migtam628/NetScope/firmware/os/README.md

# Device OS integration

Example systemd units for the engine and the kiosk UI. They describe the intended setup (docs/13) and have **not been run on a device**: there is no OS image, device-tree overlay or update bundle in this repository yet.
