migtam628/NetScope/hardware/kicad/coprocessor-pins.md

# Coprocessor pin plan (U40, STM32G0B1CBU6, UFQFPN-48)

Generated by `tools/gen_kicad.py` from `tools/main_sheets.py`; the schematic sheet is drawn from the same table.
Functions in the last column are checked against the alternate-function list in KiCad's library symbol.
Not yet checked against the reference manual: boot entry through PA14-BOOT0 and the UCPD dead-battery pins.

| Pin | Name | Net | Peripheral function |
|---|---|---|---|
| 1 | PC13 | KEY_PWR | SYS_WKUP2 |
| 2 | PC14 | WM_MUX_EN | GPIO |
| 3 | PC15 | WM_RANGE0 | GPIO |
| 4 | VBAT | +3V3_AON | supply |
| 5 | VREF+ | +3V3_AON | supply |
| 6 | VDD | +3V3_AON | supply |
| 7, 49 | VSS | GND | supply |
| 8 | PF0 | WM_RANGE1 | GPIO |
| 9 | PF1 | SFP_PWR_EN | GPIO |
| 10 | PF2 | COPROC_NRST | GPIO |
| 11 | PA0 | WM_ADC_V | ADC1_IN0 |
| 12 | PA1 | WM_ADC_I | ADC1_IN1 |
| 13 | PA2 | COPROC_UART_TX_R | USART2_TX |
| 14 | PA3 | COPROC_UART_RX | USART2_RX |
| 15 | PA4 | XT_ADC | ADC1_IN4 |
| 16 | PA5 | CC1_SENSE | ADC1_IN5 |
| 17 | PA6 | CC2_SENSE | ADC1_IN6 |
| 18 | PA7 | BUZZ | TIM17_CH1 |
| 19 | PB0 | LED3 | TIM3_CH3 |
| 20 | PB1 | LED4 | TIM3_CH4 |
| 21 | PB2 | WM_RET_A1 | GPIO |
| 22 | PB10 | POE_I2C_SCL | I2C2_SCL |
| 23 | PB11 | POE_I2C_SDA | I2C2_SDA |
| 24 | PB12 | CHG_INT | GPIO |
| 25 | PB13 | POE_ISO_EN | GPIO |
| 26 | PB14 | RELAY_TEST_EN | GPIO |
| 27 | PB15 | SOM_PWR_EN | GPIO |
| 28 | PA8 | SOM_RUN | GPIO |
| 29 | PA9/UCPD1_DBCC1 | WM_DRV_A0 | GPIO |
| 30 | PC6 | LED1 | TIM3_CH1 |
| 31 | PC7 | LED2 | TIM3_CH2 |
| 32 | PA10/UCPD1_DBCC2 | WM_DRV_A1 | GPIO |
| 33 | PA9/PA11 | WM_DRV_A2 | GPIO |
| 34 | PA10/PA12 | WM_RET_A0 | GPIO |
| 35 | PA13 | SWDIO | SYS_SWDIO |
| 36 | PA14 | SWCLK | SYS_SWCLK |
| 37 | PA15 | KEY_FN | GPIO |
| 38 | PD0 | KEY_UP | GPIO |
| 39 | PD1 | KEY_DOWN | GPIO |
| 40 | PD2 | KEY_LEFT | GPIO |
| 41 | PD3 | KEY_RIGHT | GPIO |
| 42 | PB3 | WM_RET_A2 | GPIO |
| 43 | PB4 | SPARE_PB4 | GPIO |
| 44 | PB5 | KEY_OK | SYS_WKUP6 |
| 45 | PB6 | KEY_BACK | GPIO |
| 46 | PB7 | KEY_HOME | GPIO |
| 47 | PB8 | PWR_I2C_SCL | I2C1_SCL |
| 48 | PB9 | PWR_I2C_SDA | I2C1_SDA |
