migtam628/NetScope/hardware/pcb/floorplan_report.md

# Floorplan report

Generated by `tools/render_floorplan.py`. Geometry checks on approximate part envelopes; not a layout review.

- main: 88 x 88 mm = 78.3 cm2 with tabs; placed part area 65.9 cm2 = 43% of both sides (before passives and routing)
- lower: 88 x 56 mm = 49.3 cm2 with tabs; placed part area 8.0 cm2 = 8% of both sides (before passives and routing)

## Nets crossing between the boards (8)

`KEYS`, `STATUS_LEDS`, `BUZZ`, `USBC_VBUS`, `USBC_D`, `USBC_CC`, `+3V3_AON`, `GND`

These set the board-to-board cables (J50 signal, J51 power).

## Violations

None.
