migtam628/NetScope/mechanical/out/check_report.md

# Enclosure check report

Generated by `mechanical/enclosure.py`. Geometry checks only: this is not a tolerance analysis, drop simulation or mouldability review.

| Part | Valid solid | Bodies | Bounding box (mm) | Volume (cm3) | Mass (g) |
|---|---|---:|---|---:|---:|
| front_shell | yes | 1 | 108.0 x 212.0 x 15.5 | 57.3 | 66 |
| rear_shell | yes | 1 | 108.0 x 212.0 x 26.8 | 83.1 | 96 |
| battery_door | yes | 1 | 73.4 x 79.4 x 2.5 | 14.5 | 17 |
| bumper | yes | 1 | 114.0 x 218.0 x 30.0 | 51.1 | 61 |

## Interference (shell vs. module keep-outs)

| Shell part | Module | Overlap (mm3) |
|---|---|---:|
| front_shell | ref_display | 0.0 |
| front_shell | pcb_main | 0.0 |
| front_shell | pcb_lower | 0.0 |
| front_shell | ref_cells | 0.0 |
| rear_shell | ref_display | 0.0 |
| rear_shell | pcb_main | 0.0 |
| rear_shell | pcb_lower | 0.0 |
| rear_shell | ref_cells | 0.0 |
| battery_door | ref_display | 0.0 |
| battery_door | pcb_main | 0.0 |
| battery_door | pcb_lower | 0.0 |
| battery_door | ref_cells | 0.0 |

## Interference between internal modules

| Module | Module | Overlap (mm3) |
|---|---|---:|
| ref_display | pcb_main | 0.0 |
| ref_display | pcb_lower | 0.0 |
| ref_display | ref_cells | 0.0 |
| pcb_main | pcb_lower | 0.0 |
| pcb_main | ref_cells | 0.0 |
| pcb_lower | ref_cells | 0.0 |

## Depth stack at the battery

front wall 2.5 + display 8.0 + gap 2.0 + PCB 1.6 + clearance 0.6 + cell 21.6 + clearance 0.6 + door 2.5 = **39.4 mm** against 40.0 mm outside depth (fits, +0.6 mm).

Overall result: **pass**
