migtam628/NetScope/docs/img/ui-autodiagnose.png

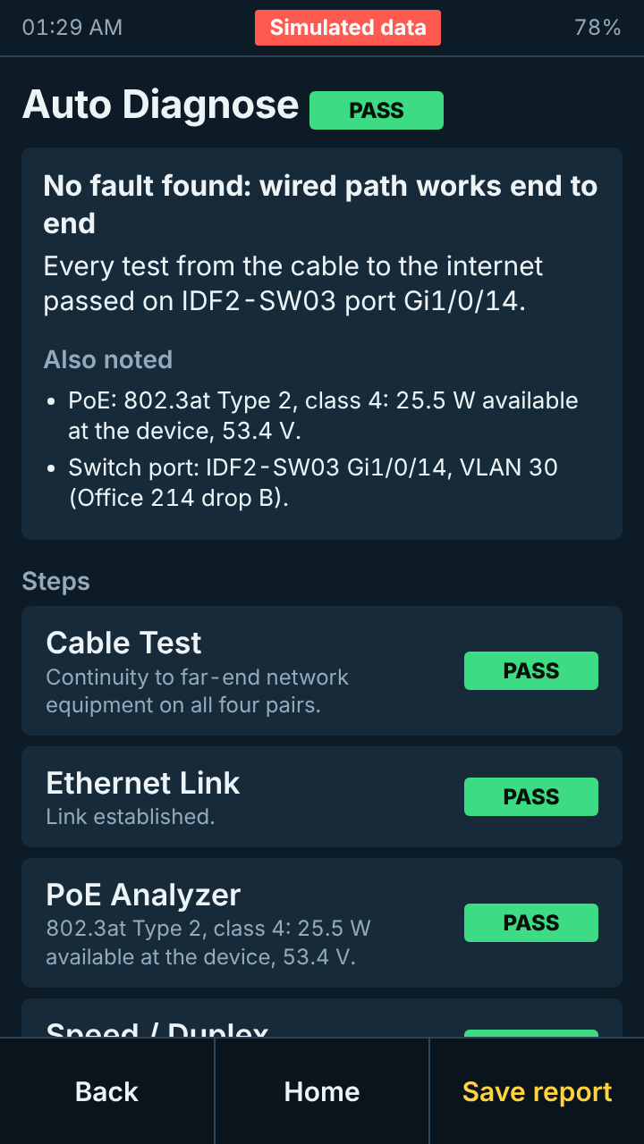
docs/img/ui-autodiagnose.png
