migtam628/NetScope/docs/img/ui-fiber.png

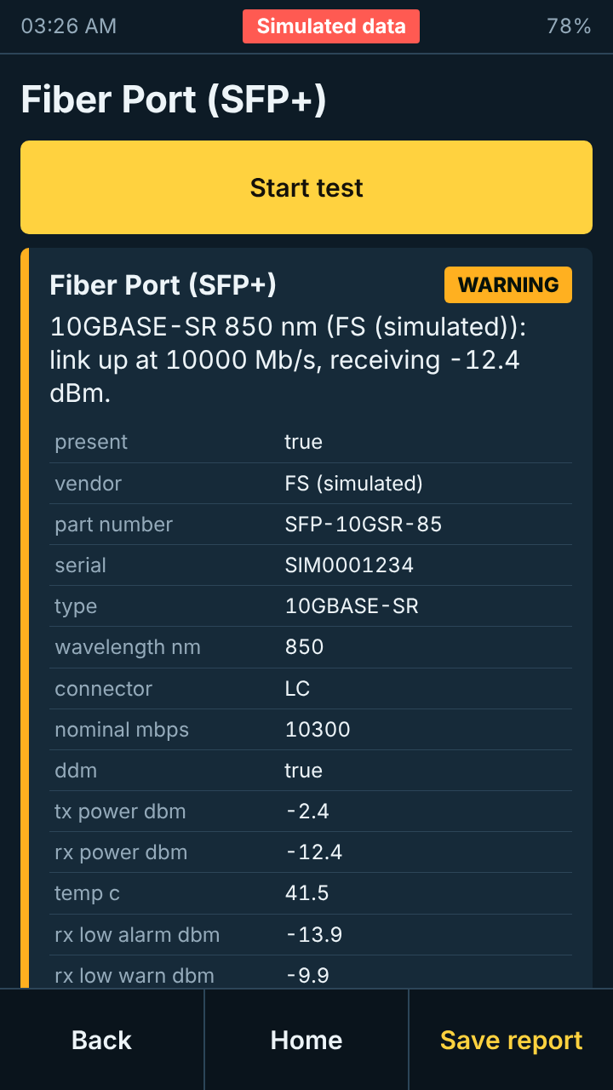
docs/img/ui-fiber.png
