migtam628/NetScope/mechanical/renders/01_front.png

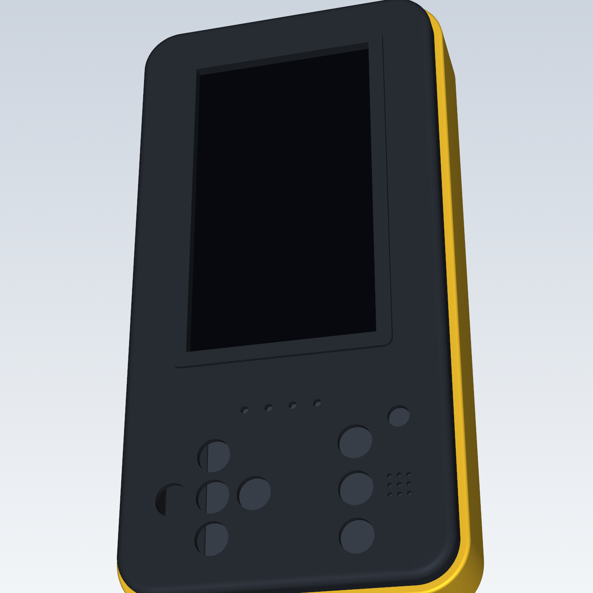
mechanical/renders/01_front.png
