migtam628/NetScope/mechanical/renders/02_back.png

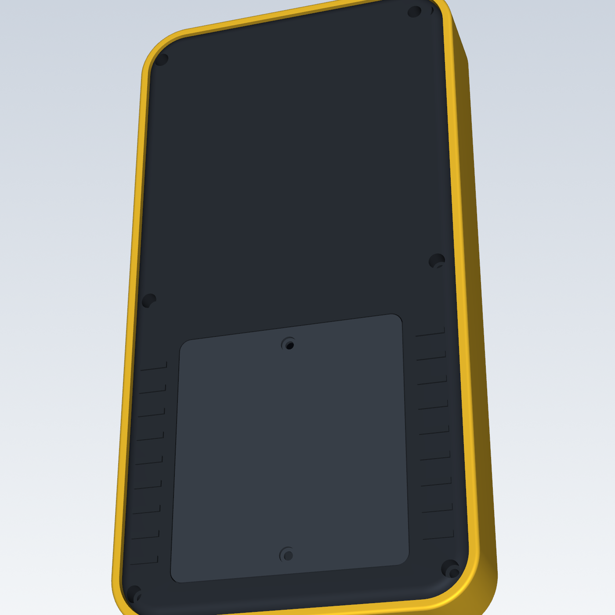
mechanical/renders/02_back.png
