migtam628/NetScope/mechanical/renders/03_top_end_ports.png

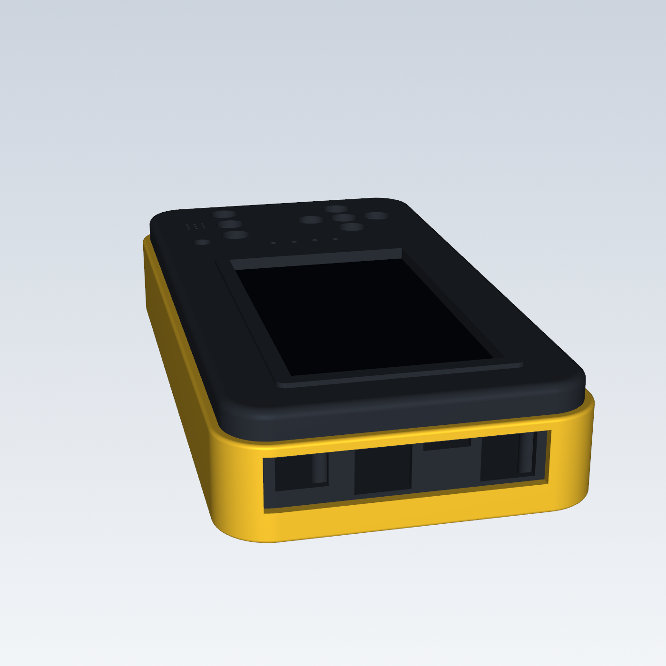
mechanical/renders/03_top_end_ports.png
