migtam628/NetScope/mechanical/renders/04_boards_in_rear_shell.png

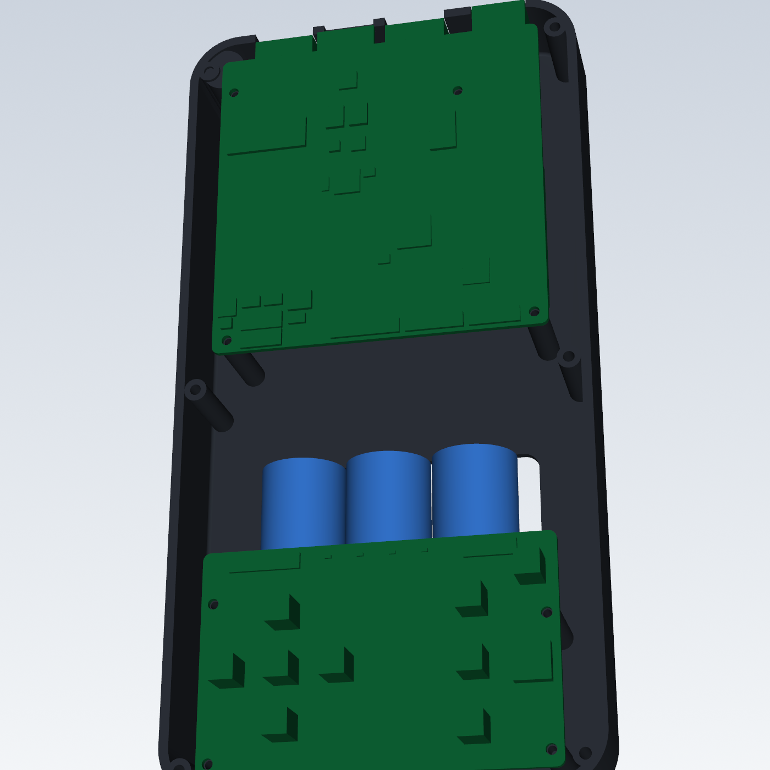
mechanical/renders/04_boards_in_rear_shell.png
