migtam628/NetScope/mechanical/renders/05_boards_back_side.png

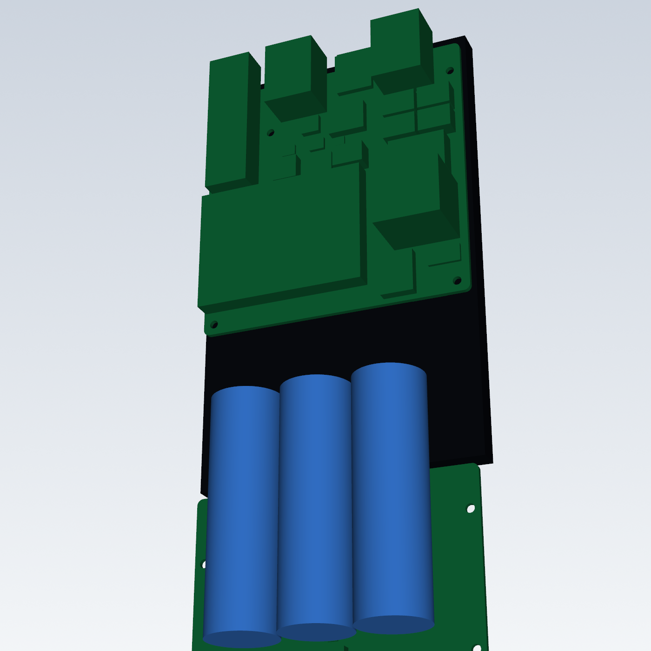
mechanical/renders/05_boards_back_side.png
