migtam628/NetScope/mechanical/renders/06_exploded.png

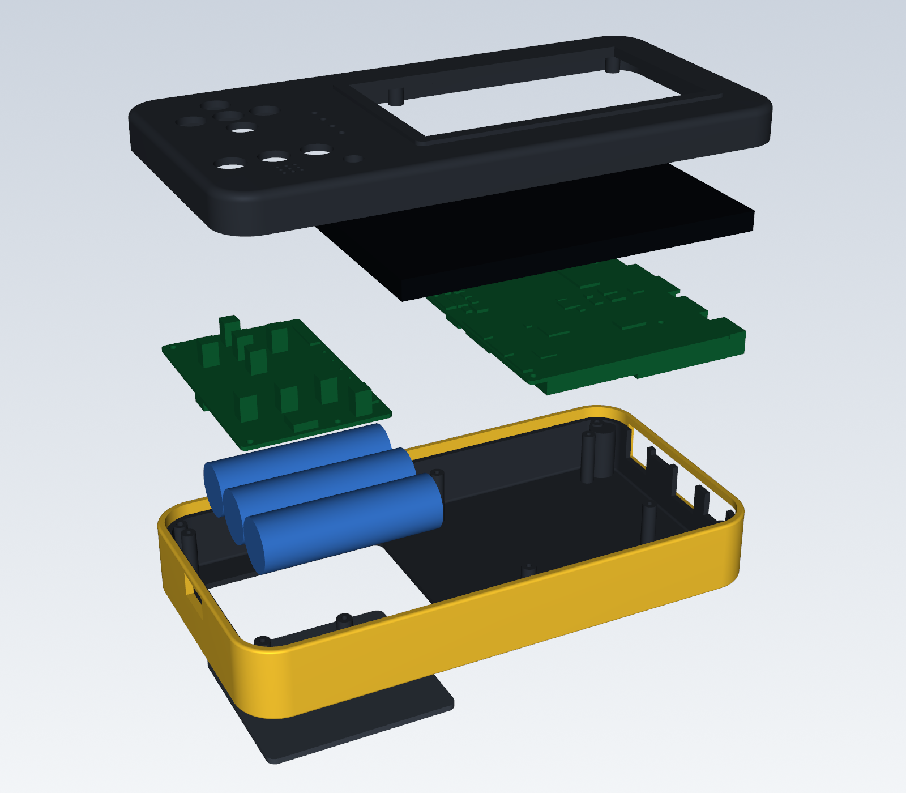
mechanical/renders/06_exploded.png
