migtam628/NetScope/docs/14-bom-and-cost.md

# 14 - Bill of materials and cost estimate

Generated by `tools/cost_rollup.py` from `hardware/bom/bom.csv`.

**These are planning estimates, not quotes.** Unit costs were entered from general knowledge of 2026 pricing and have not been checked line by line against live distributor stock. Two were checked against published list prices on 2026-11-10: the Compute Module 5 family (the maker's July 2026 product brief) and the 5 inch Touch Display 2 ($40 list). Quote every line before ordering.

## Cost per unit

| | 1 | 10 | 100 | 1,000 |
|---|---:|---:|---:|---:|
| Electronic parts | $395 | $391 | $334 | $293 |
| PCB, assembly, mechanics, terminator, test | $349 | $239 | $118 | $49 |
| **Total per unit** | **$744** | **$630** | **$452** | **$341** |
| Optional (microSD reader, M.2 socket) | +$4.2 | +$4.2 | +$3.1 | +$2.5 |

Not included: injection-mould tooling (budget $25k-$45k for two shells, bumper and keypad), regulatory testing (FCC Part 15B and battery UN38.3 at minimum; budget $8k-$20k, see `docs/10`), engineering time, scrap, freight, tariffs and margin.

Prototype run of 5 boards: about $3,721 in parts and services, plus a second spin (assume one).

## Part-number confidence

- **known** (18): an orderable part number I am confident exists. Suffix, package and stock still need checking.
- **candidate** (16): believed suitable; confirm against the datasheet.
- **tbd** (14): only the requirement is fixed. Selecting these is Phase 2/3 work.

## Lines

| Refs | Qty | Description | Manufacturer / MPN | Status | $ @1 | $ @100 | $ @1k | Find | Alternates | Supply risk |
|---|---:|---|---|---|---:|---:|---:|---|---|---|
| M1 | 1 | Compute Module 5, wireless, 2 GB RAM, 16 GB eMMC | Raspberry Pi CM5102016 | known | 98.00 | 98.00 | 95.00 | [DigiKey](https://www.digikey.com/en/products/result?keywords=CM5102016) [Mouser](https://www.mouser.com/c/?q=CM5102016) | CM5104032 (4 GB/32 GB); CM5 Lite + industrial microSD | Single source. Maker states production to at least Jan 2036. Price rose during 2026 with memory costs: re-quote. |
| J2 J3 | 2 | 100-pin 0.4 mm board-to-board, CM5 mating half | Hirose DF40C-100DS-0.4V(51) | known | 1.90 | 1.40 | 1.10 | [DigiKey](https://www.digikey.com/en/products/result?keywords=DF40C-100DS-0.4V%2851%29) [Mouser](https://www.mouser.com/c/?q=DF40C-100DS-0.4V%2851%29) | none (defined by the module) | Mature part |
| J1 | 1 | 5 in 720x1280 DSI capacitive touch display | Raspberry Pi Touch Display 2 (5 inch) | known | 40.00 | 40.00 | 38.00 | [DigiKey](https://www.digikey.com/en/products/result?keywords=Touch+Display+2+%285+inch%29) [Mouser](https://www.mouser.com/c/?q=Touch+Display+2+%285+inch%29) | Waveshare 5-DSI-TOUCH-B class panel (needs driver check) | Maker states production to at least Jan 2030: shortest-lived major part. Plan a second source before volume. |
| J10 | 1 | RJ45 8P8C shielded, THT, no magnetics | Amphenol RJHSE-5380 | candidate | 2.50 | 1.80 | 1.40 | [DigiKey](https://www.digikey.com/en/products/result?keywords=RJHSE-5380) [Mouser](https://www.mouser.com/c/?q=RJHSE-5380) | Any shielded 8P8C without magnetics with >= 1.5 A/contact | Commodity |
| J11 | 1 | RJ45 with integrated 1000BASE-T magnetics and LEDs | TBD  | tbd | 5.50 | 4.00 | 3.20 |  | Bel / Pulse / Wurth 1G MagJack; use the CM5 IO board part as the reference | Commodity; pick one stocked by two distributors |
| K1 K2 K3 K4 | 4 | DPDT signal relay, 3 V coil, non-latching, >= 1 A carry, low-capacitance contacts | Omron G6K-2F-Y DC3 | candidate | 3.20 | 2.40 | 1.90 | [DigiKey](https://www.digikey.com/en/products/result?keywords=G6K-2F-Y+DC3) [Mouser](https://www.mouser.com/c/?q=G6K-2F-Y+DC3) | Panasonic TQ2SA-3V; Kemet EC2-3NU | Mature. Must be characterised for gigabit return loss (see risks R-03). |
| T1 | 1 | 1000BASE-T transformer module, 4 centre taps brought out, 802.3bt Type 4 current rating, 1500 Vrms | Wurth Elektronik WE-LAN 4PPoE 1000BASE-T (7490220120 / 7490220123: confirm variant) | candidate | 6.00 | 4.20 | 3.20 | [DigiKey](https://www.digikey.com/en/products/result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) [Mouser](https://www.mouser.com/c/?q=WE-LAN+4PPoE+1000BASE-T+%287490220120+%2F+7490220123%3A+confirm+variant%29) | Pulse / Bel / Bourns 4PPoE-rated discrete gigabit transformer | Family is sold as 802.3bt 4PPoE but centre-tap ratings differ by variant (800 mA to 1000 mA seen). Type 4 needs about 960 mA per pair set: choose the variant from the datasheet current rating. Not yet done. |
| U10 | 1 | Gigabit Ethernet PHY, RGMII, LinkMD cable diagnostics | Microchip KSZ9131RNXI | known | 4.20 | 3.40 | 2.90 | [DigiKey](https://www.digikey.com/en/products/result?keywords=KSZ9131RNXI) [Mouser](https://www.mouser.com/c/?q=KSZ9131RNXI) | Analog Devices ADIN1300 (also has mainline cable test); Marvell 88E1512 (harder to buy) | Active part, mainline Linux driver with cable test |
| U11 | 1 | USB 3.1 Gen 1 to RGMII Ethernet MAC | Microchip LAN7801-I/9JX | known | 7.50 | 6.00 | 5.20 | [DigiKey](https://www.digikey.com/en/products/result?keywords=LAN7801-I%2F9JX) [Mouser](https://www.mouser.com/c/?q=LAN7801-I%2F9JX) | Realtek RTL8153 (integrated PHY, no mainline cable test - loses TDR) | Active part, mainline lan78xx driver |
| Y1 Y2 | 2 | 25 MHz crystal, 20 ppm | TBD  | tbd | 0.60 | 0.40 | 0.30 |  | any 25 MHz 3225 crystal meeting the PHY/MAC datasheet | Commodity |
| D10 | 2 | 4-line low-capacitance TVS array, PHY side | Semtech RClamp0524P | candidate | 1.20 | 0.80 | 0.60 | [DigiKey](https://www.digikey.com/en/products/result?keywords=RClamp0524P) [Mouser](https://www.mouser.com/c/?q=RClamp0524P) | TI TPD4E05U06; Littelfuse SP3012 | Commodity |
| PROT1 | 1 | 8x (PTC resettable fuse + 2.2 k pulse resistor + bidirectional TVS) | various  | tbd | 4.00 | 2.80 | 2.00 |  | n/a | Passives |
| U30 U31 | 2 | 8:1 analog mux, +/-15 V, latch-up immune | Analog Devices ADG5408BRUZ | known | 9.50 | 7.50 | 6.20 | [DigiKey](https://www.digikey.com/en/products/result?keywords=ADG5408BRUZ) [Mouser](https://www.mouser.com/c/?q=ADG5408BRUZ) | ADG1408 (not latch-up immune); TI MUX508 | Active part |
| U32 | 1 | Precision dual op-amp, RRIO, 36 V | Texas Instruments OPA2192IDR | candidate | 3.50 | 2.60 | 2.10 | [DigiKey](https://www.digikey.com/en/products/result?keywords=OPA2192IDR) [Mouser](https://www.mouser.com/c/?q=OPA2192IDR) | ADA4522-2; OPA2189 | Active part |
| U33 | 1 | Tone driver + log/peak detector for pair-to-pair coupling (design not finalised) | TBD  | tbd | 4.00 | 3.00 | 2.20 |  | n/a | EXPERIMENTAL block - see docs/03 |
| U40 | 1 | Cortex-M0+ MCU, 128 kB flash, UFQFPN-48 (0.6 mm high: the LQFP is too tall for the front side) | STMicroelectronics STM32G0B1CBU6 | candidate | 5.50 | 4.20 | 3.50 | [DigiKey](https://www.digikey.com/en/products/result?keywords=STM32G0B1CBU6) [Mouser](https://www.mouser.com/c/?q=STM32G0B1CBU6) | STM32G0B1CCU6 (256 kB) | Active, 10-year longevity program |
| SW1 | 9 | Tactile switch 6 mm, 2.6 N, under silicone keypad | C&K PTS645 series | candidate | 0.35 | 0.22 | 0.15 | [DigiKey](https://www.digikey.com/en/products/result?keywords=PTS645+series) [Mouser](https://www.mouser.com/c/?q=PTS645+series) | Alps SKHH; E-Switch TL3301 | Commodity |
| LED1 | 4 | Status LED 0603 (2x green, 1x amber, 1x red/green) | various  | tbd | 0.30 | 0.15 | 0.08 |  | n/a | Commodity |
| BZ1 | 1 | SMD piezo transducer, ~4 kHz, >= 80 dB at 10 cm | TBD  | tbd | 1.20 | 0.90 | 0.70 |  | CUI / PUI / Murata SMD piezo | Commodity |
| D20 D21 | 8 | Schottky rectifier 100 V 2 A (two discrete bridges) | Vishay SS2H10 | candidate | 0.45 | 0.30 | 0.22 | [DigiKey](https://www.digikey.com/en/products/result?keywords=SS2H10) [Mouser](https://www.mouser.com/c/?q=SS2H10) | Any 100 V / 2 A Schottky in SMB/SMA | Commodity |
| D22 | 1 | TVS 58 V 400 W unidirectional | Littelfuse SMAJ58A | known | 0.40 | 0.20 | 0.12 | [DigiKey](https://www.digikey.com/en/products/result?keywords=SMAJ58A) [Mouser](https://www.mouser.com/c/?q=SMAJ58A) | Vishay SMAJ58A; Bourns SMAJ58A | Commodity, multi-source |
| U21 | 1 | IEEE 802.3bt Type 4 PD interface, autoclass, PSE-type indicator outputs | Texas Instruments TPS2372-4RGWR | known | 3.90 | 3.00 | 2.40 | [DigiKey](https://www.digikey.com/en/products/result?keywords=TPS2372-4RGWR) [Mouser](https://www.mouser.com/c/?q=TPS2372-4RGWR) | TPS2373-4 (adds DC/DC enable features) | Active part |
| U22 | 1 | 85 V 20-bit current/voltage/power monitor, I2C | Texas Instruments INA228AIDGSR | known | 5.20 | 4.00 | 3.30 | [DigiKey](https://www.digikey.com/en/products/result?keywords=INA228AIDGSR) [Mouser](https://www.mouser.com/c/?q=INA228AIDGSR) | INA238 (16-bit) | Active part |
| U23 | 1 | 16-bit 4-channel I2C ADC (centre-tap voltages) | Texas Instruments ADS1115IDGSR | known | 5.50 | 4.00 | 3.20 | [DigiKey](https://www.digikey.com/en/products/result?keywords=ADS1115IDGSR) [Mouser](https://www.mouser.com/c/?q=ADS1115IDGSR) | ADS1015 (12-bit, sufficient) | Active part |
| U24 | 1 | 8-bit I2C GPIO expander | Texas Instruments TCA9534APWR | known | 1.10 | 0.80 | 0.60 | [DigiKey](https://www.digikey.com/en/products/result?keywords=TCA9534APWR) [Mouser](https://www.mouser.com/c/?q=TCA9534APWR) | NXP PCA9534 | Multi-source |
| Q20 | 6 | N-MOSFET 100 V, logic-level gate, >= 3 A | TBD  | tbd | 0.90 | 0.60 | 0.45 |  | many | Commodity |
| R20 | 6 | Power resistor TO-220 20 W, pulse rated (values in docs/04) | Bourns PWR220T-20 series | candidate | 3.20 | 2.40 | 1.90 | [DigiKey](https://www.digikey.com/en/products/result?keywords=PWR220T-20+series) [Mouser](https://www.mouser.com/c/?q=PWR220T-20+series) | Vishay LTO 30; Ohmite TCH35 | Commodity |
| U25 | 1 | Comparator + NTC hardware over-temperature cut-off for the load | TBD  | tbd | 1.00 | 0.70 | 0.50 |  | any micropower comparator | Commodity |
| U20 | 1 | Bidirectional I2C isolator, reinforced | Texas Instruments ISO1640BDR | candidate | 3.60 | 2.80 | 2.30 | [DigiKey](https://www.digikey.com/en/products/result?keywords=ISO1640BDR) [Mouser](https://www.mouser.com/c/?q=ISO1640BDR) | ISO1540; Analog Devices ADuM1250 | Active part |
| PS1 | 1 | Isolated DC/DC 5 V to 5 V, 1 W, >= 1.5 kVdc | Murata Power Solutions NXJ1S0505MC-R7 | candidate | 5.50 | 4.20 | 3.50 | [DigiKey](https://www.digikey.com/en/products/result?keywords=NXJ1S0505MC-R7) [Mouser](https://www.mouser.com/c/?q=NXJ1S0505MC-R7) | Murata NXE1S0505MC-R7 (3 kVdc); RECOM R1SX / CUI PDSE1 class | Listed at DigiKey with a 21-week factory lead time (checked 2026-11-11): buy prototype stock early. Unregulated output: check 5 V tolerance at light load. Price not checked. |
| J20 | 1 | USB Type-C 2.0 receptacle, 16-pin | GCT USB4105-GF-A | candidate | 0.90 | 0.65 | 0.50 | [DigiKey](https://www.digikey.com/en/products/result?keywords=USB4105-GF-A) [Mouser](https://www.mouser.com/c/?q=USB4105-GF-A) | Amphenol 12401610E4#2A; Molex 216990 | Commodity |
| D30 | 1 | 4-channel USB ESD array | Texas Instruments TPD4E05U06DQAR | known | 0.50 | 0.35 | 0.25 | [DigiKey](https://www.digikey.com/en/products/result?keywords=TPD4E05U06DQAR) [Mouser](https://www.mouser.com/c/?q=TPD4E05U06DQAR) | Nexperia PRTR5V0U4D | Multi-source |
| U50 | 1 | 1-cell 5 A I2C buck charger with power path and ADC | Texas Instruments BQ25895RTWR | known | 4.60 | 3.50 | 2.90 | [DigiKey](https://www.digikey.com/en/products/result?keywords=BQ25895RTWR) [Mouser](https://www.mouser.com/c/?q=BQ25895RTWR) | BQ25896 (3 A) | Active part |
| U51 | 1 | 1-cell fuel gauge, ModelGauge m5, no characterisation needed | Analog Devices MAX17055ETB+T | known | 3.80 | 2.90 | 2.40 | [DigiKey](https://www.digikey.com/en/products/result?keywords=MAX17055ETB%2BT) [Mouser](https://www.mouser.com/c/?q=MAX17055ETB%2BT) | TI BQ27441 (needs chemistry config) | Active part |
| BT1 | 1 | Li-ion pack 1S3P 21700, ~15 Ah / 54 Wh, PCM + 10 k NTC, UN38.3 tested | custom pack house  | tbd | 38.00 | 30.00 | 24.00 |  | 1S2P 10 Ah (shorter runtime, see docs/06) | Custom pack: 6-10 week lead time; needs UN38.3 report for shipping |
| U52 | 1 | 10 A synchronous boost, VBAT to 5.1 V | Texas Instruments TPS61088RHLR | known | 3.60 | 2.70 | 2.20 | [DigiKey](https://www.digikey.com/en/products/result?keywords=TPS61088RHLR) [Mouser](https://www.mouser.com/c/?q=TPS61088RHLR) | TPS61089; MPS MP3423 | Active part |
| L1 | 1 | Power inductor 1.5 uH, Isat >= 12 A, 7 x 7 mm | Coilcraft XAL7030-152 (suffix to confirm) | candidate | 1.50 | 1.00 | 0.80 | [DigiKey](https://www.digikey.com/en/products/result?keywords=XAL7030-152+%28suffix+to+confirm%29) [Mouser](https://www.mouser.com/c/?q=XAL7030-152+%28suffix+to+confirm%29) | Coilcraft XAL / Wurth WE-LHMI class | Commodity |
| U53 | 1 | 60 nA IQ buck, 3.3 V always-on | Texas Instruments TPS62840DLCR | known | 1.90 | 1.40 | 1.10 | [DigiKey](https://www.digikey.com/en/products/result?keywords=TPS62840DLCR) [Mouser](https://www.mouser.com/c/?q=TPS62840DLCR) | TPS62A01 (higher IQ) | Active part |
| U54 | 1 | 2 A buck, 5 V to 3.3 V | Texas Instruments TLV62569DBVR | known | 0.70 | 0.45 | 0.30 | [DigiKey](https://www.digikey.com/en/products/result?keywords=TLV62569DBVR) [Mouser](https://www.mouser.com/c/?q=TLV62569DBVR) | many pin-compatible SOT-23 bucks | Multi-source |
| U55 | 1 | Split-rail DC/DC, 5 V to +/-15 V | Texas Instruments TPS65131RGER | candidate | 4.20 | 3.20 | 2.60 | [DigiKey](https://www.digikey.com/en/products/result?keywords=TPS65131RGER) [Mouser](https://www.mouser.com/c/?q=TPS65131RGER) | Charge-pump doubler/inverter pair | Active part |
| U60 | 1 | USB 2.0 SD card reader controller (DNP option) | Microchip USB2244 | candidate | 3.00 | 2.30 | 1.90 | [DigiKey](https://www.digikey.com/en/products/result?keywords=USB2244) [Mouser](https://www.mouser.com/c/?q=USB2244) | Genesys GL823K | Option, not populated on rev A |
| J30 | 1 | microSD push-push socket (DNP option) | TBD  | tbd | 1.20 | 0.80 | 0.60 |  | Molex / Hirose DM3 | Option |
| U70 | 1 | 10G Ethernet MAC, PCIe x1 to SFP+ (XFI), FCBGA 7 x 11 mm | Marvell (Aquantia) AQC100-B1-C | candidate | 25.00 | 25.00 | 25.00 | [DigiKey](https://www.digikey.com/en/products/result?keywords=AQC100-B1-C) [Mouser](https://www.mouser.com/c/?q=AQC100-B1-C) | Realtek RTL8127ATF (fiber-only 10G, single-lane PCIe, about 1 W; retail cards exist). Not sold by DigiKey/Mouser; Linux driver support for the fiber variant NOT confirmed | SUPPLY RISK. DigiKey on 2026-11-11: $25.00 each, sold only in trays of 210, none in stock, backorders not accepted (constrained supply). Prototype quantities would have to come from a broker or from Marvell directly. 1 Gb module support is indicated by the maker's adapter brief but not proven at chip level. |
| J32 | 1 | SFP+ cage, 1x1, press-fit, with 20-pin host connector and EMI springs | TBD  | tbd | 4.50 | 3.20 | 2.40 |  | TE / Molex / Amphenol 1x1 SFP+ cage and connector | Commodity. Replaces the M.2 option, which used the same PCIe lane. |
| J40 J41 | 2 | Tag-Connect TC2030 pads (SWD) and test pads (SoM console, boot): no fitted part | various  | tbd | 0.80 | 0.30 | 0.10 |  | n/a | Proto only |
| - | 1 | Resistors, capacitors, ferrites, small inductors (~260 placements) | various  | tbd | 14.00 | 7.00 | 4.50 |  | n/a | Commodity |
| - | 1 | Main board: 6-layer 1.6 mm FR-4 TG170, ENIG, controlled impedance, 88 x 88 mm + tab | fab house  | tbd | 40.00 | 10.00 | 5.50 |  | n/a | Standard stackup at any controlled-impedance fab |
| - | 1 | Keypad and USB-C board: 2-layer 1.6 mm FR-4, ENIG, 88 x 56 mm | fab house  | tbd | 12.00 | 2.20 | 1.20 |  | n/a | Commodity |
| J50 J51 | 1 | Board-to-board link: 30-way and 20-way 0.5 mm flat-flex cables with four low-profile (1.0 mm) connectors | TBD  | tbd | 6.50 | 4.40 | 3.20 |  | Molex / Hirose / TE 0.5 mm FFC, back-flip, 1.0 mm high | Power cable carries 5 A across 10 conductors each way: check the connector current rating |
| - | 1 | SMT assembly of both boards, double-sided main board, AOI + X-ray for QFN and BGA | CM  | tbd | 135.00 | 31.00 | 15.50 |  | n/a | Setup cost dominates below 100 units |
| - | 1 | Two-shell PC/ABS housing + TPU bumper | -  | tbd | 85.00 | 45.00 | 11.00 |  | n/a | 1/10: MJF nylon prints. 100: urethane casting. 1000: injection moulding (tooling NRE not included) |
| - | 1 | Silicone keypad with light pipes | -  | tbd | 20.00 | 6.00 | 2.20 |  | n/a | Custom tooling at volume |
| - | 1 | Aluminium heat spreader for PoE load + SoM | -  | tbd | 6.00 | 3.00 | 1.80 |  | n/a | CNC then stamped |
| - | 1 | 2.4/5 GHz antenna with U.FL pigtail | Raspberry Pi Compute Module 4/5 Antenna Kit | known | 4.00 | 4.00 | 3.50 | [DigiKey](https://www.digikey.com/en/products/result?keywords=Compute+Module+4%2F5+Antenna+Kit) [Mouser](https://www.mouser.com/c/?q=Compute+Module+4%2F5+Antenna+Kit) | none without re-testing radio compliance | Using the maker's antenna keeps the module's radio certification applicable (confirm with test lab) |
| - | 1 | Screws, inserts, gasket, display lens, lanyard post, labels | -  | tbd | 12.00 | 6.00 | 3.50 |  | n/a | Commodity |
| - | 1 | RT-1 remote terminator (one included per unit) | -  | tbd | 9.00 | 5.00 | 3.00 |  | n/a | See hardware/remote-terminator: rev A board and its own BOM; cost here is still an estimate |
| - | 1 | Programming, calibration and functional test labour | -  | tbd | 30.00 | 10.00 | 5.00 |  | n/a | Needs the fixture from docs/09 |
