migtam628/NetScope/hardware/kicad/netscope-x1-lower/fab-rev-a/lower-bom.csv

Refs | Value | Footprint | MPN | Manufacturer | Qty
BZ1 | CPT-9019S-SMT | Buzzer_Beeper:Buzzer_CUI_CPT-9019S-SMT | CPT-9019S-SMT | CUI Devices | 1
C1 | 4u7 25V | Capacitor_SMD:C_0805_2012Metric |  |  | 1
C11-C19 | 100n | Capacitor_SMD:C_0603_1608Metric |  |  | 9
D30 | USBLC6-2P6 | Package_TO_SOT_SMD:SOT-666 | USBLC6-2P6 | STMicroelectronics | 1
J20 | USB-C 16P | Connector_USB:USB_C_Receptacle_GCT_USB4105-xx-A_16P_TopMnt_Horizontal | USB4105-GF-A | GCT | 1
J50 | FH12-30S-0.5SH | Connector_FFC-FPC:Hirose_FH12-30S-0.5SH_1x30-1MP_P0.50mm_Horizontal | FH12-30S-0.5SH(55) | Hirose | 1
J51 | FH12-20S-0.5SH | Connector_FFC-FPC:Hirose_FH12-20S-0.5SH_1x20-1MP_P0.50mm_Horizontal | FH12-20S-0.5SH(55) | Hirose | 1
LED1-LED4 | LED 0603 | LED_SMD:LED_0603_1608Metric |  |  | 4
R1,R2 | 5k1 | Resistor_SMD:R_0603_1608Metric |  |  | 2
R11-R19 | 10k | Resistor_SMD:R_0603_1608Metric |  |  | 9
R21-R24 | 680R | Resistor_SMD:R_0603_1608Metric |  |  | 4
R31 | 100R | Resistor_SMD:R_0603_1608Metric |  |  | 1
R32 | 4k7 | Resistor_SMD:R_0603_1608Metric |  |  | 1
SW1 | Up | Button_Switch_THT:SW_PUSH_6mm_H9.5mm |  |  | 1
SW2 | Down | Button_Switch_THT:SW_PUSH_6mm_H9.5mm |  |  | 1
SW3 | Left | Button_Switch_THT:SW_PUSH_6mm_H9.5mm |  |  | 1
SW4 | Right | Button_Switch_THT:SW_PUSH_6mm_H9.5mm |  |  | 1
SW5 | OK | Button_Switch_THT:SW_PUSH_6mm_H9.5mm |  |  | 1
SW6 | Back | Button_Switch_THT:SW_PUSH_6mm_H9.5mm |  |  | 1
SW7 | Home | Button_Switch_THT:SW_PUSH_6mm_H9.5mm |  |  | 1
SW8 | Fn | Button_Switch_THT:SW_PUSH_6mm_H9.5mm |  |  | 1
SW9 | Power | Button_Switch_THT:SW_PUSH_6mm_H9.5mm |  |  | 1
