migtam628/NetScope/mechanical/out/netscope_x1_assembly.step

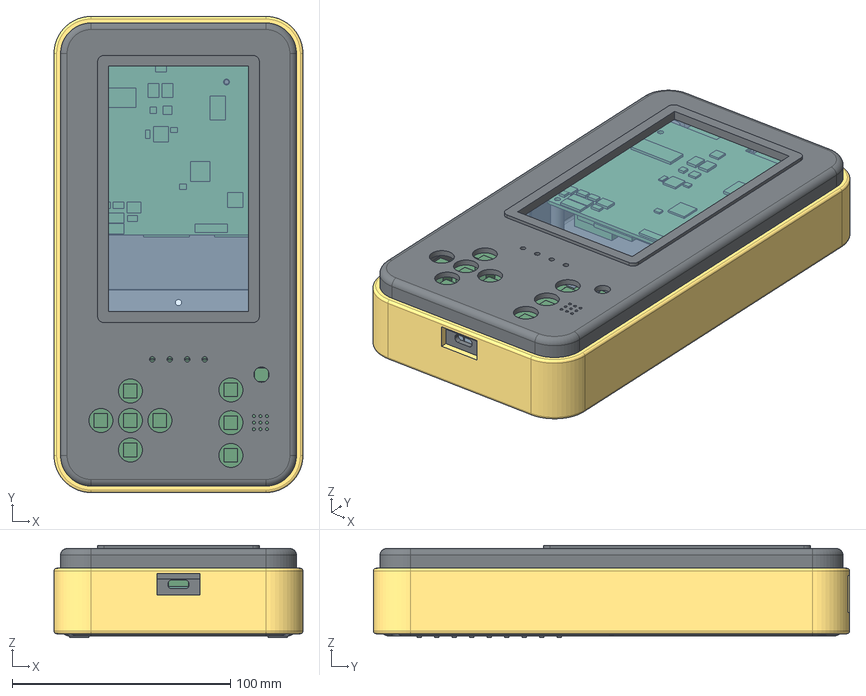
[picture p11: CAD file, 2026-11-13]
mechanical/out/netscope_x1_assembly.step
114.0 x 218.0 x 42.3 mm
front_shell
rear_shell
battery_door
bumper
ref_display
pcb_main
pcb_lower
ref_cells
