migtam628/NetScope/mechanical/out/pcb_main.step

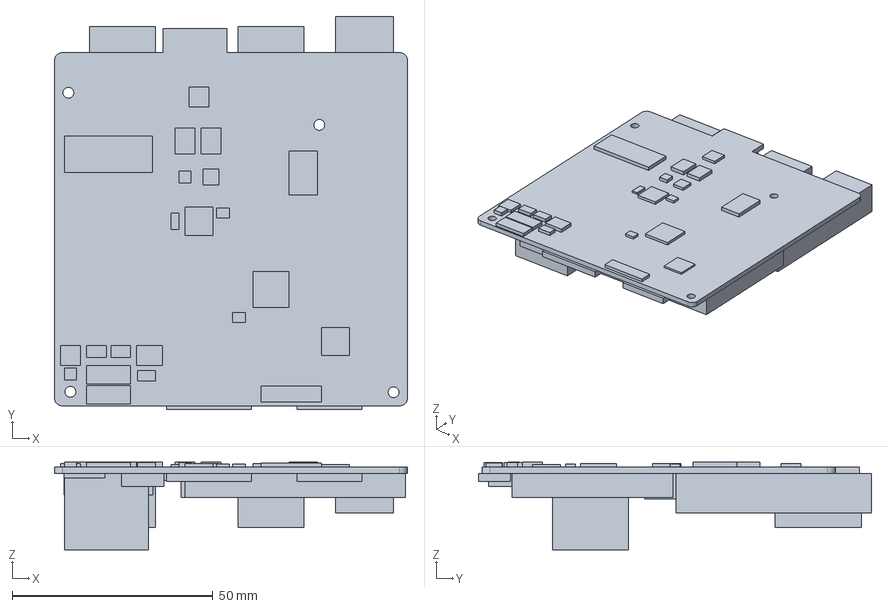
[picture p12: CAD file, 2026-11-13]
mechanical/out/pcb_main.step
88.0 x 97.9 x 21.8 mm
