migtam628/NetScope/mechanical/out/battery_door.step

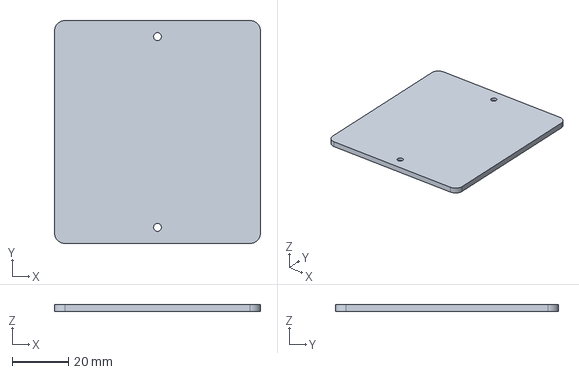
[picture p13: CAD file, 2026-11-13]
mechanical/out/battery_door.step
73.4 x 79.4 x 2.50 mm
