migtam628/NetScope/mechanical/out/rear_shell.step

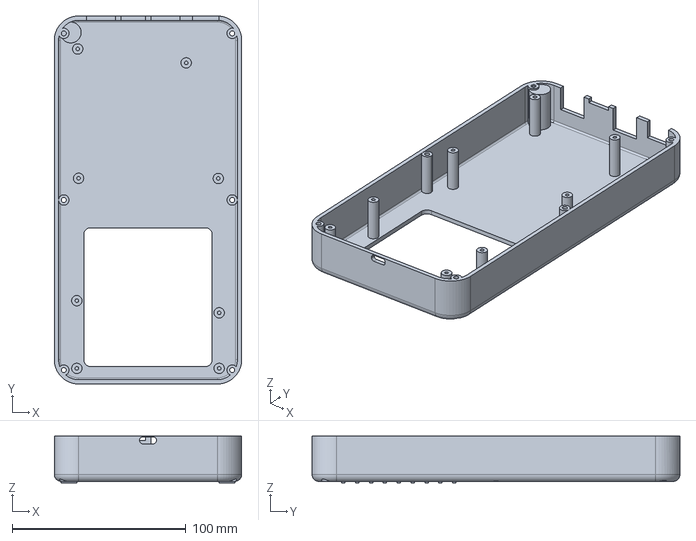
[picture p14: CAD file, 2026-11-13]
mechanical/out/rear_shell.step
108.0 x 212.0 x 26.8 mm
