migtam628/NetScope/mechanical/out/pcb_lower.step

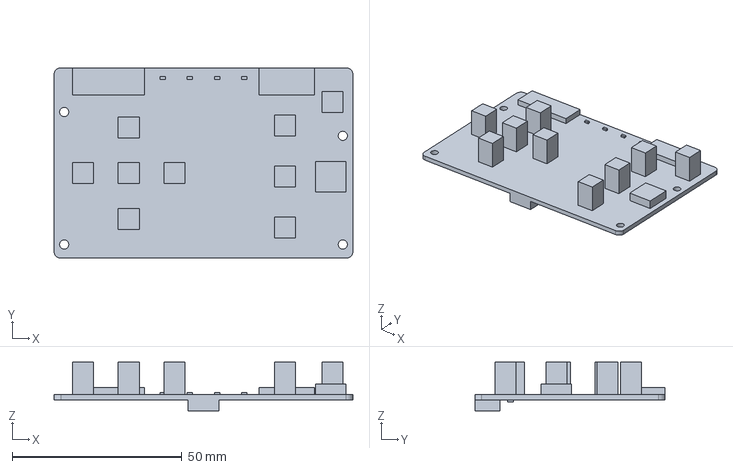
[picture p15: CAD file, 2026-11-13]
mechanical/out/pcb_lower.step
88.0 x 56.0 x 14.4 mm
