migtam628/NetScope/mechanical/out/front_shell.step

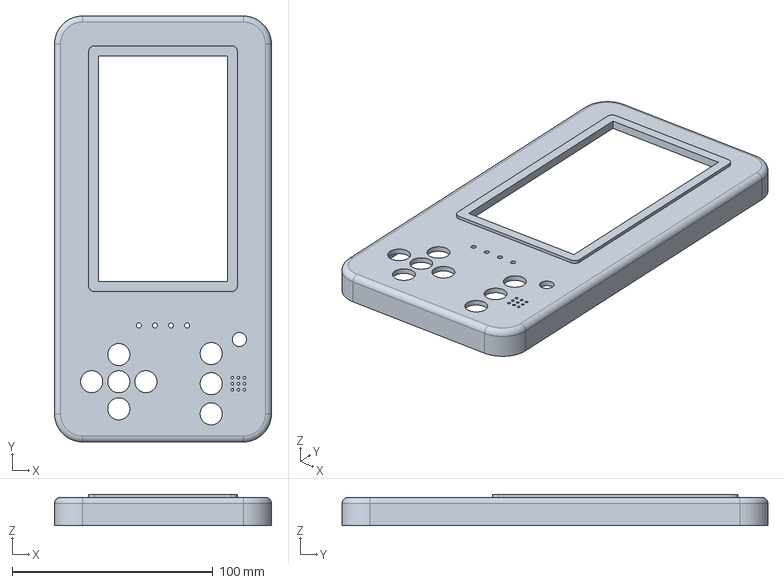
[picture p16: CAD file, 2026-11-13]
mechanical/out/front_shell.step
108.0 x 212.0 x 15.5 mm
