migtam628/NetScope/mechanical/out/bumper.step

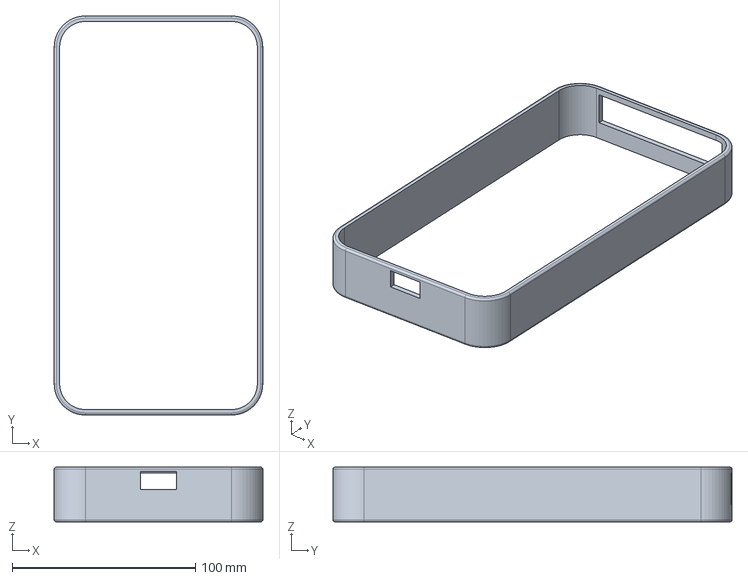
[picture p17: CAD file, 2026-11-13]
mechanical/out/bumper.step
114.0 x 218.0 x 30.0 mm
