migtam628/NetScope/mechanical/out/ref_cells.stl

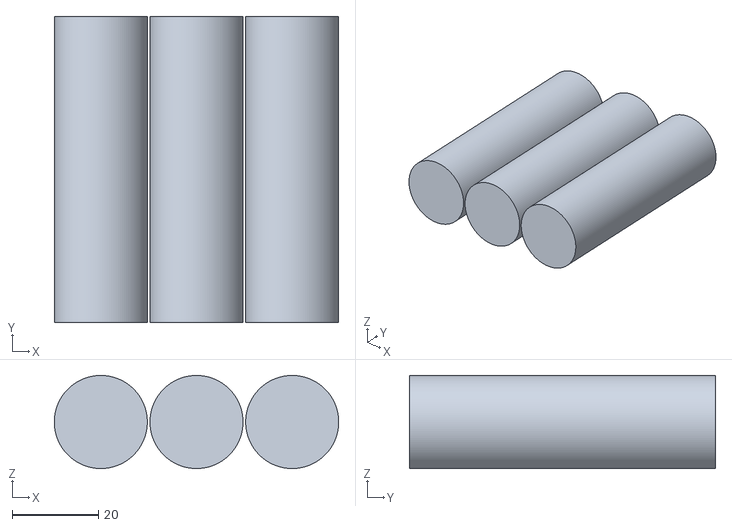
[picture p18: CAD file, 2026-11-12]
mechanical/out/ref_cells.stl
66.0 x 71.0 x 21.6
