migtam628/NetScope/mechanical/out/ref_display.stl

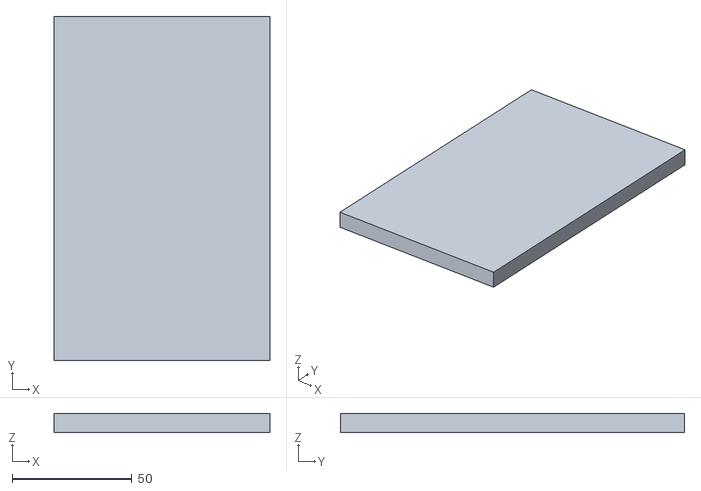
[picture p19: CAD file, 2026-11-12]
mechanical/out/ref_display.stl
90.0 x 143.5 x 8.00
