migtam628/NetScope/(list of files, cad)

Other CAD files:
mechanical/out/battery_door.3mf
mechanical/out/battery_door.stl
mechanical/out/bumper.3mf
mechanical/out/bumper.stl
mechanical/out/front_shell.3mf
mechanical/out/front_shell.stl
mechanical/out/pcb_lower.stl
mechanical/out/pcb_main.stl
mechanical/out/rear_shell.3mf
mechanical/out/rear_shell.stl
