migtam628/NetScope/docs/spike/RESULTS.md

# Spike results

Nothing has been measured yet. Fill one block per step; keep raw output files next to this file.

| Field | Value |
|---|---|
| Date | |
| Who | |
| Repo commit | |
| Kernel / OS image | |
| Boards used (part numbers, revisions) | |

## Step 1 - engine and UI on the SoM
Result: not run
Boot time (s): - Idle power (W): - Active power (W): -
Bugs found in `hal/linux.py`: -

## Step 2 - TDR
Result: not run
| Cable | True length (m) | Pair A | Pair B | Pair C | Pair D |
|---|---|---|---|---|---|

## Step 3 - PoE
Result: not run

## Step 4 - wiremap
Result: not run

## Step 5 - relay
Result: not run

## Step 6 - 10 Gb fiber controller
Result: not run
Gen 2 throughput (Gb/s): - Gen 3 throughput (Gb/s): - 1 Gb module links: - Extra power (W): -

## Decisions taken as a result
-
