migtam628/NetScope/hardware/kicad/netscope-x1-kicad-schematic.pdf

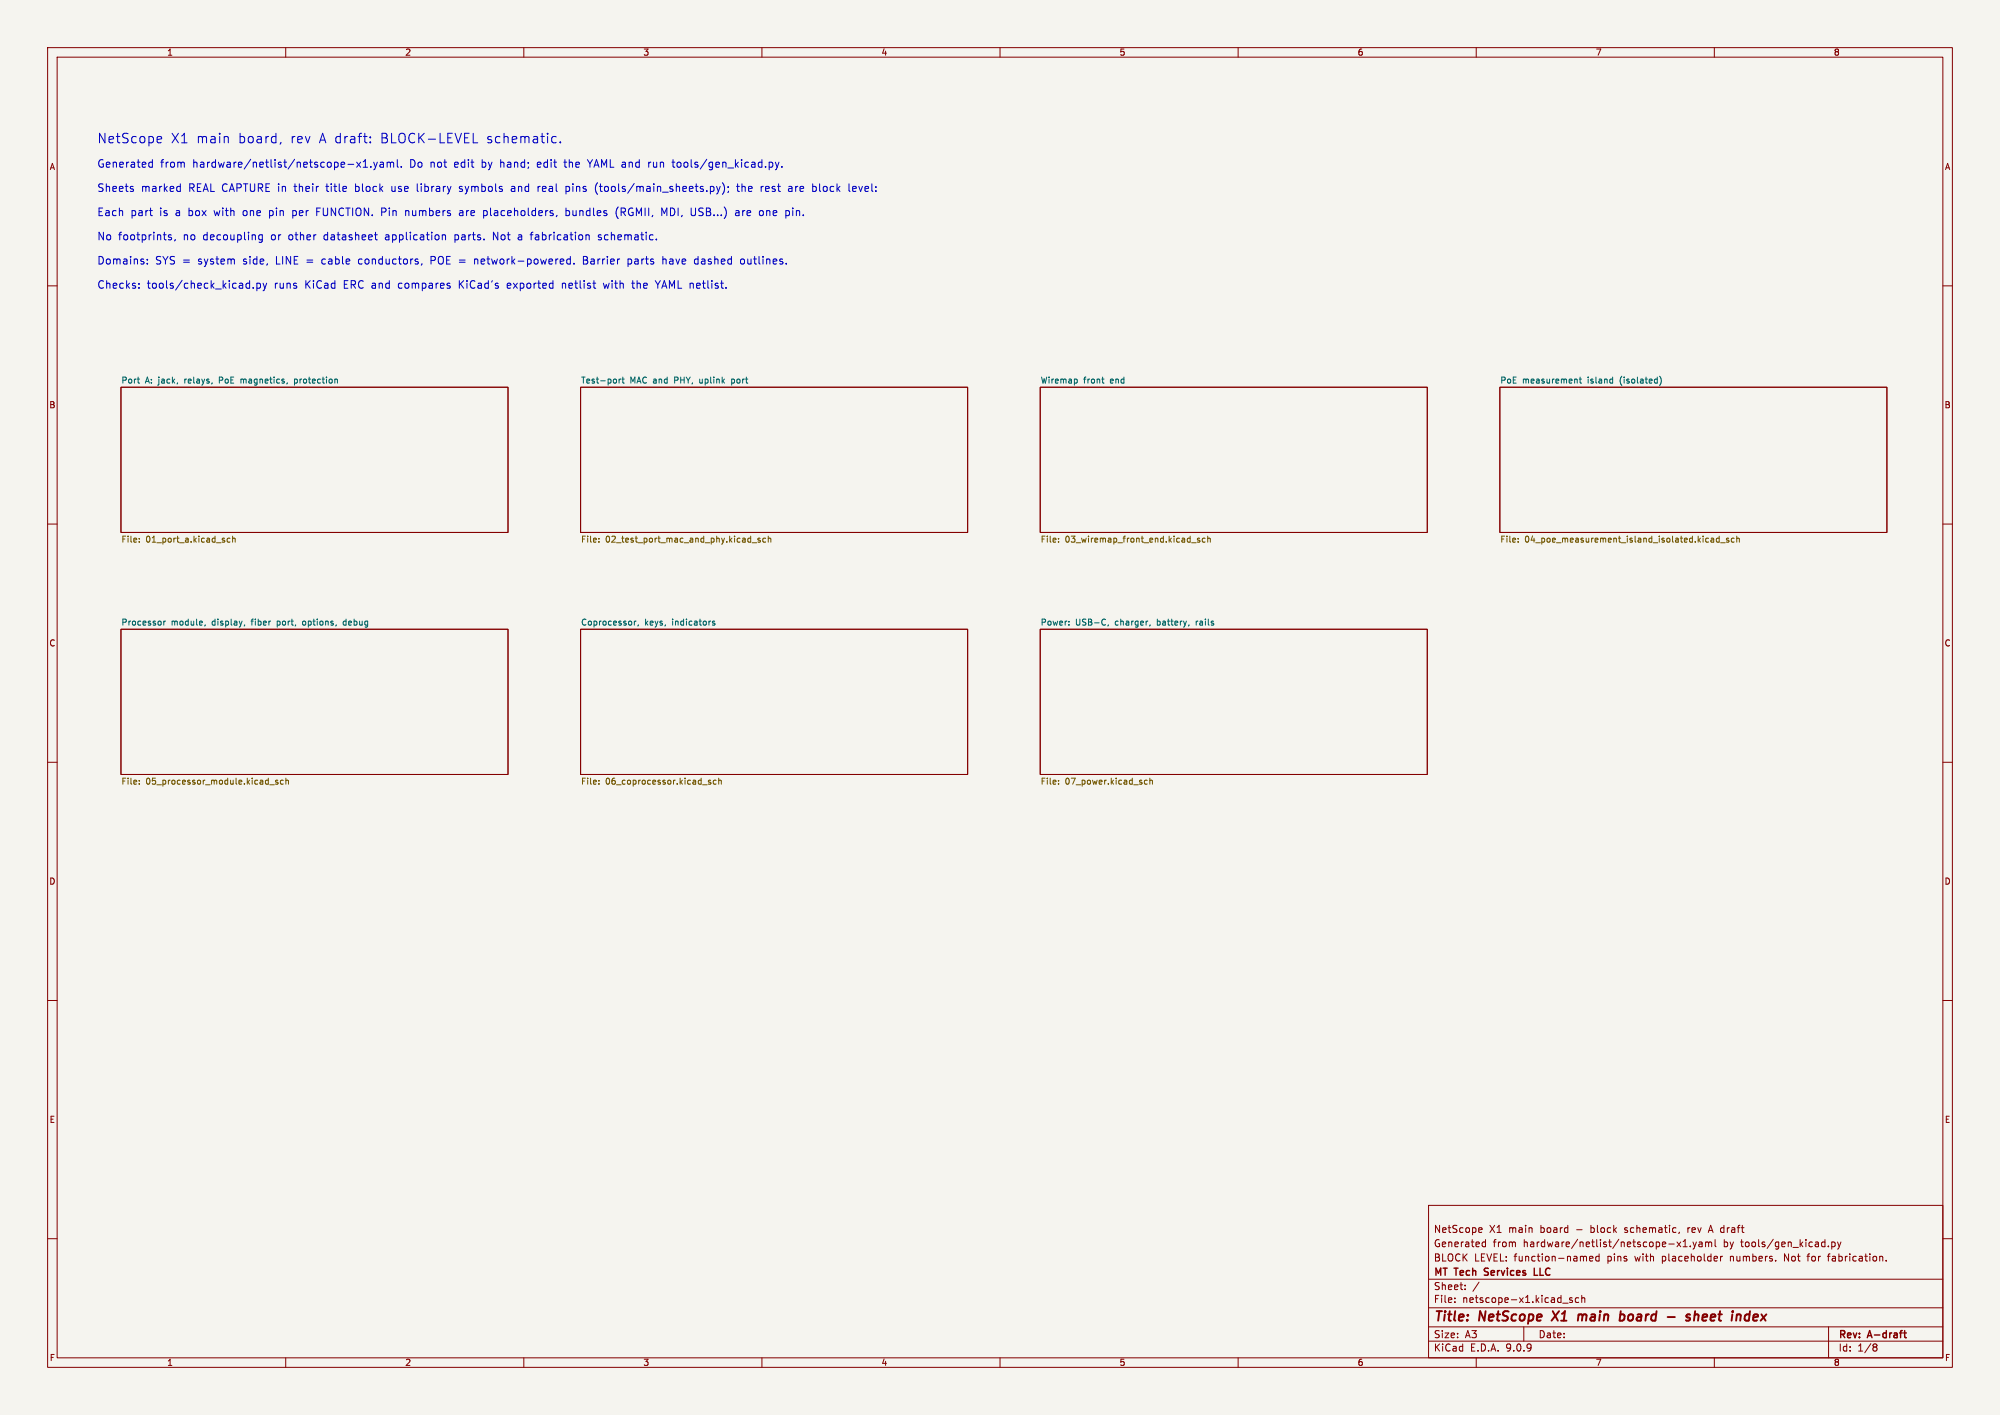
[picture p20: page 1]

NetScope X1 main board, rev A draft: BLOCK-LEVEL schematic.

Id: 1/8 Title: NetScope X1 main board - sheet index

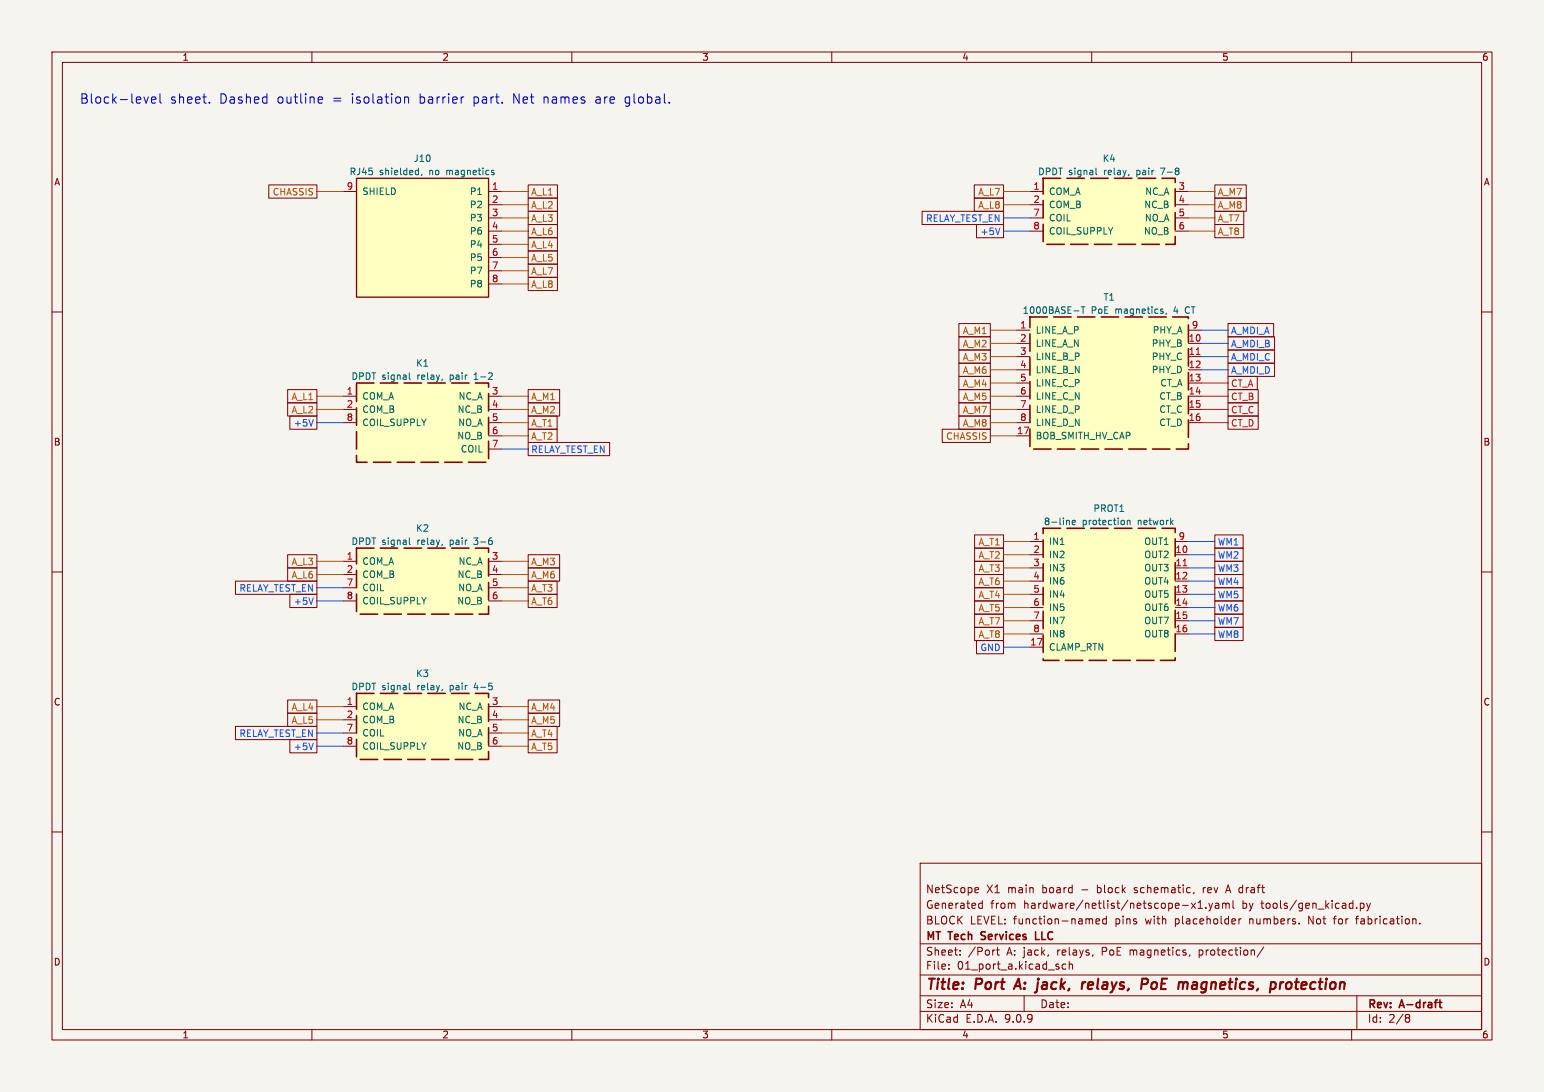
[picture p21: page 2]

Id: 2/8 Title: Port A: jack, relays, PoE magnetics, protection

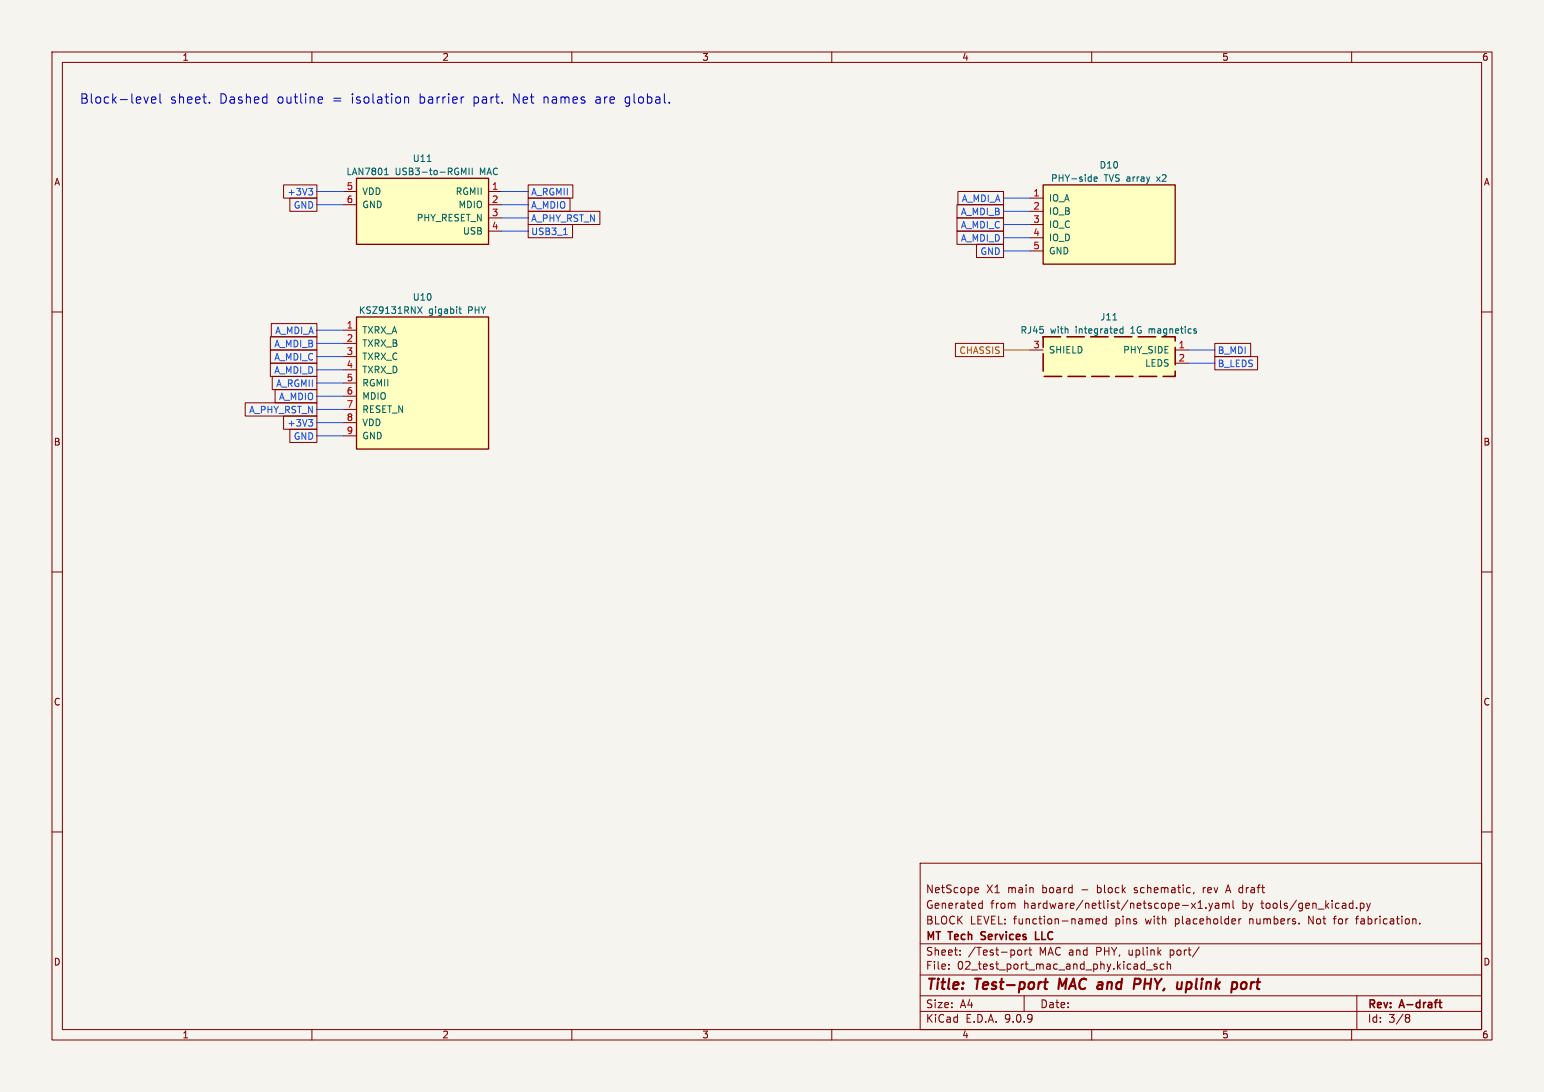
[picture p22: page 3]

BLOCK LEVEL: function-named | from | hardware/netlist/netscope-x1.yaml | pins with | placeholder | by tools/gen_kicad.py numbers. Not for fabrication. Generated

Tech Services | MAC and LLC MAC and PHY, uplink port File: 02_test_port_mac_and_phy.kicad_sch Sheet: /Test-port | PHY, uplink port/ MT Id: 3/8 Title: Test-port

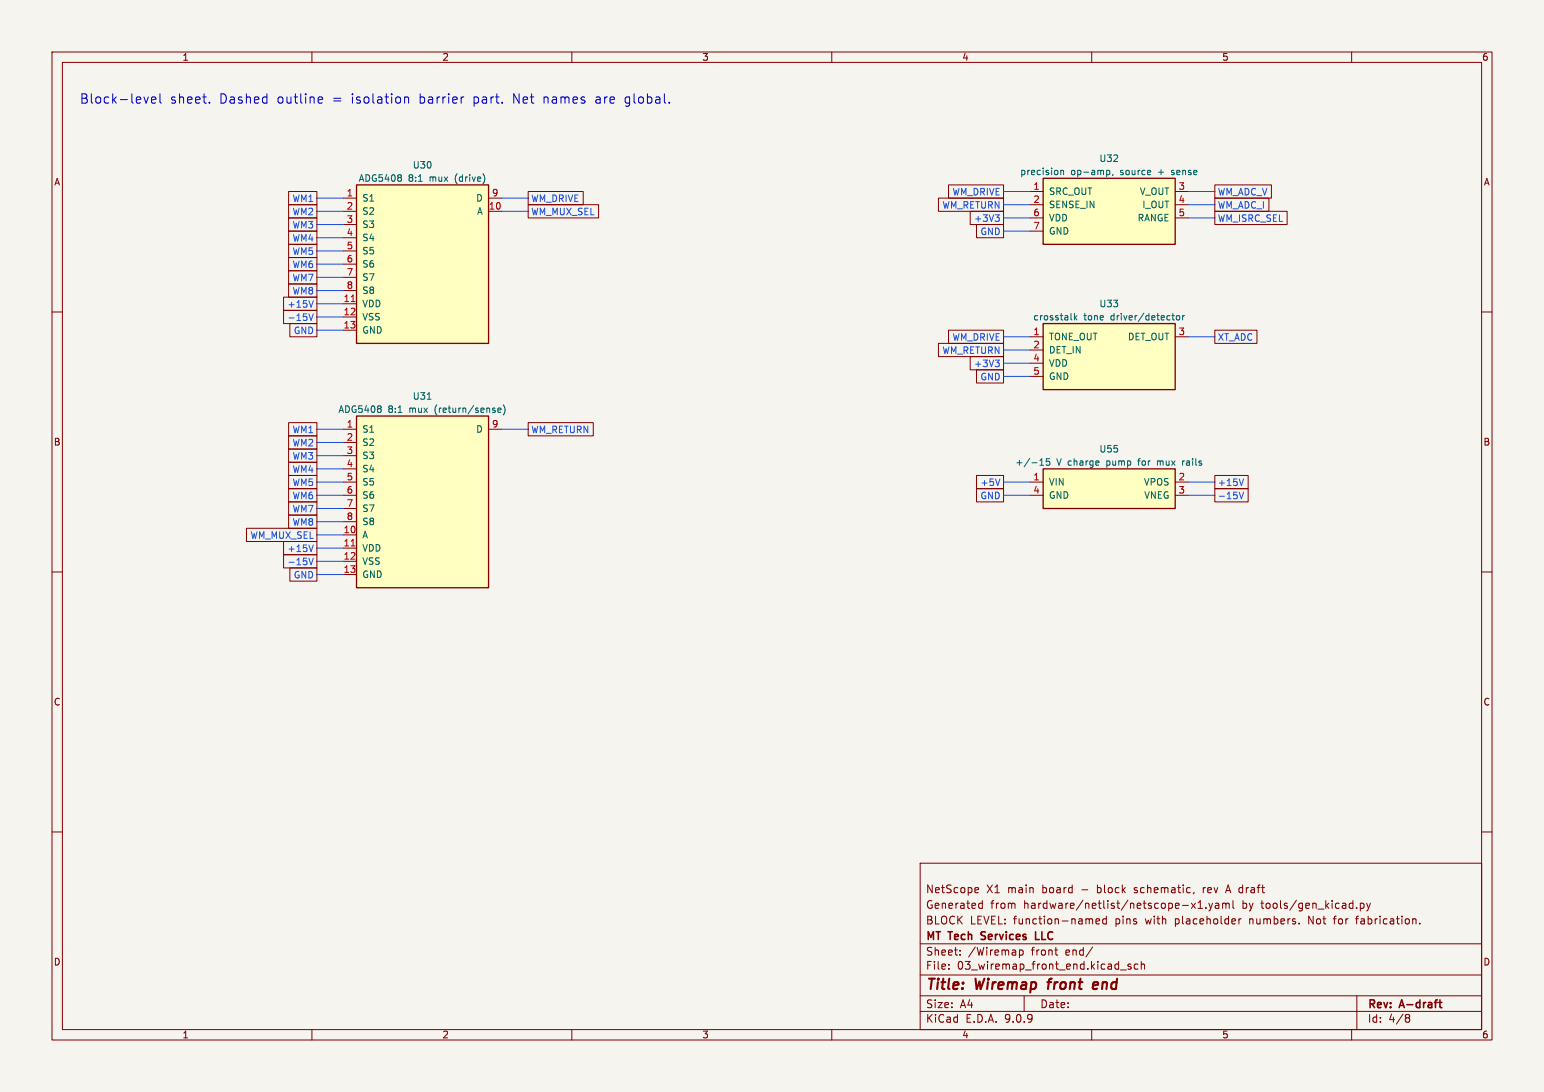
[picture p23: page 4]

Id: 4/8 Title: Wiremap front end

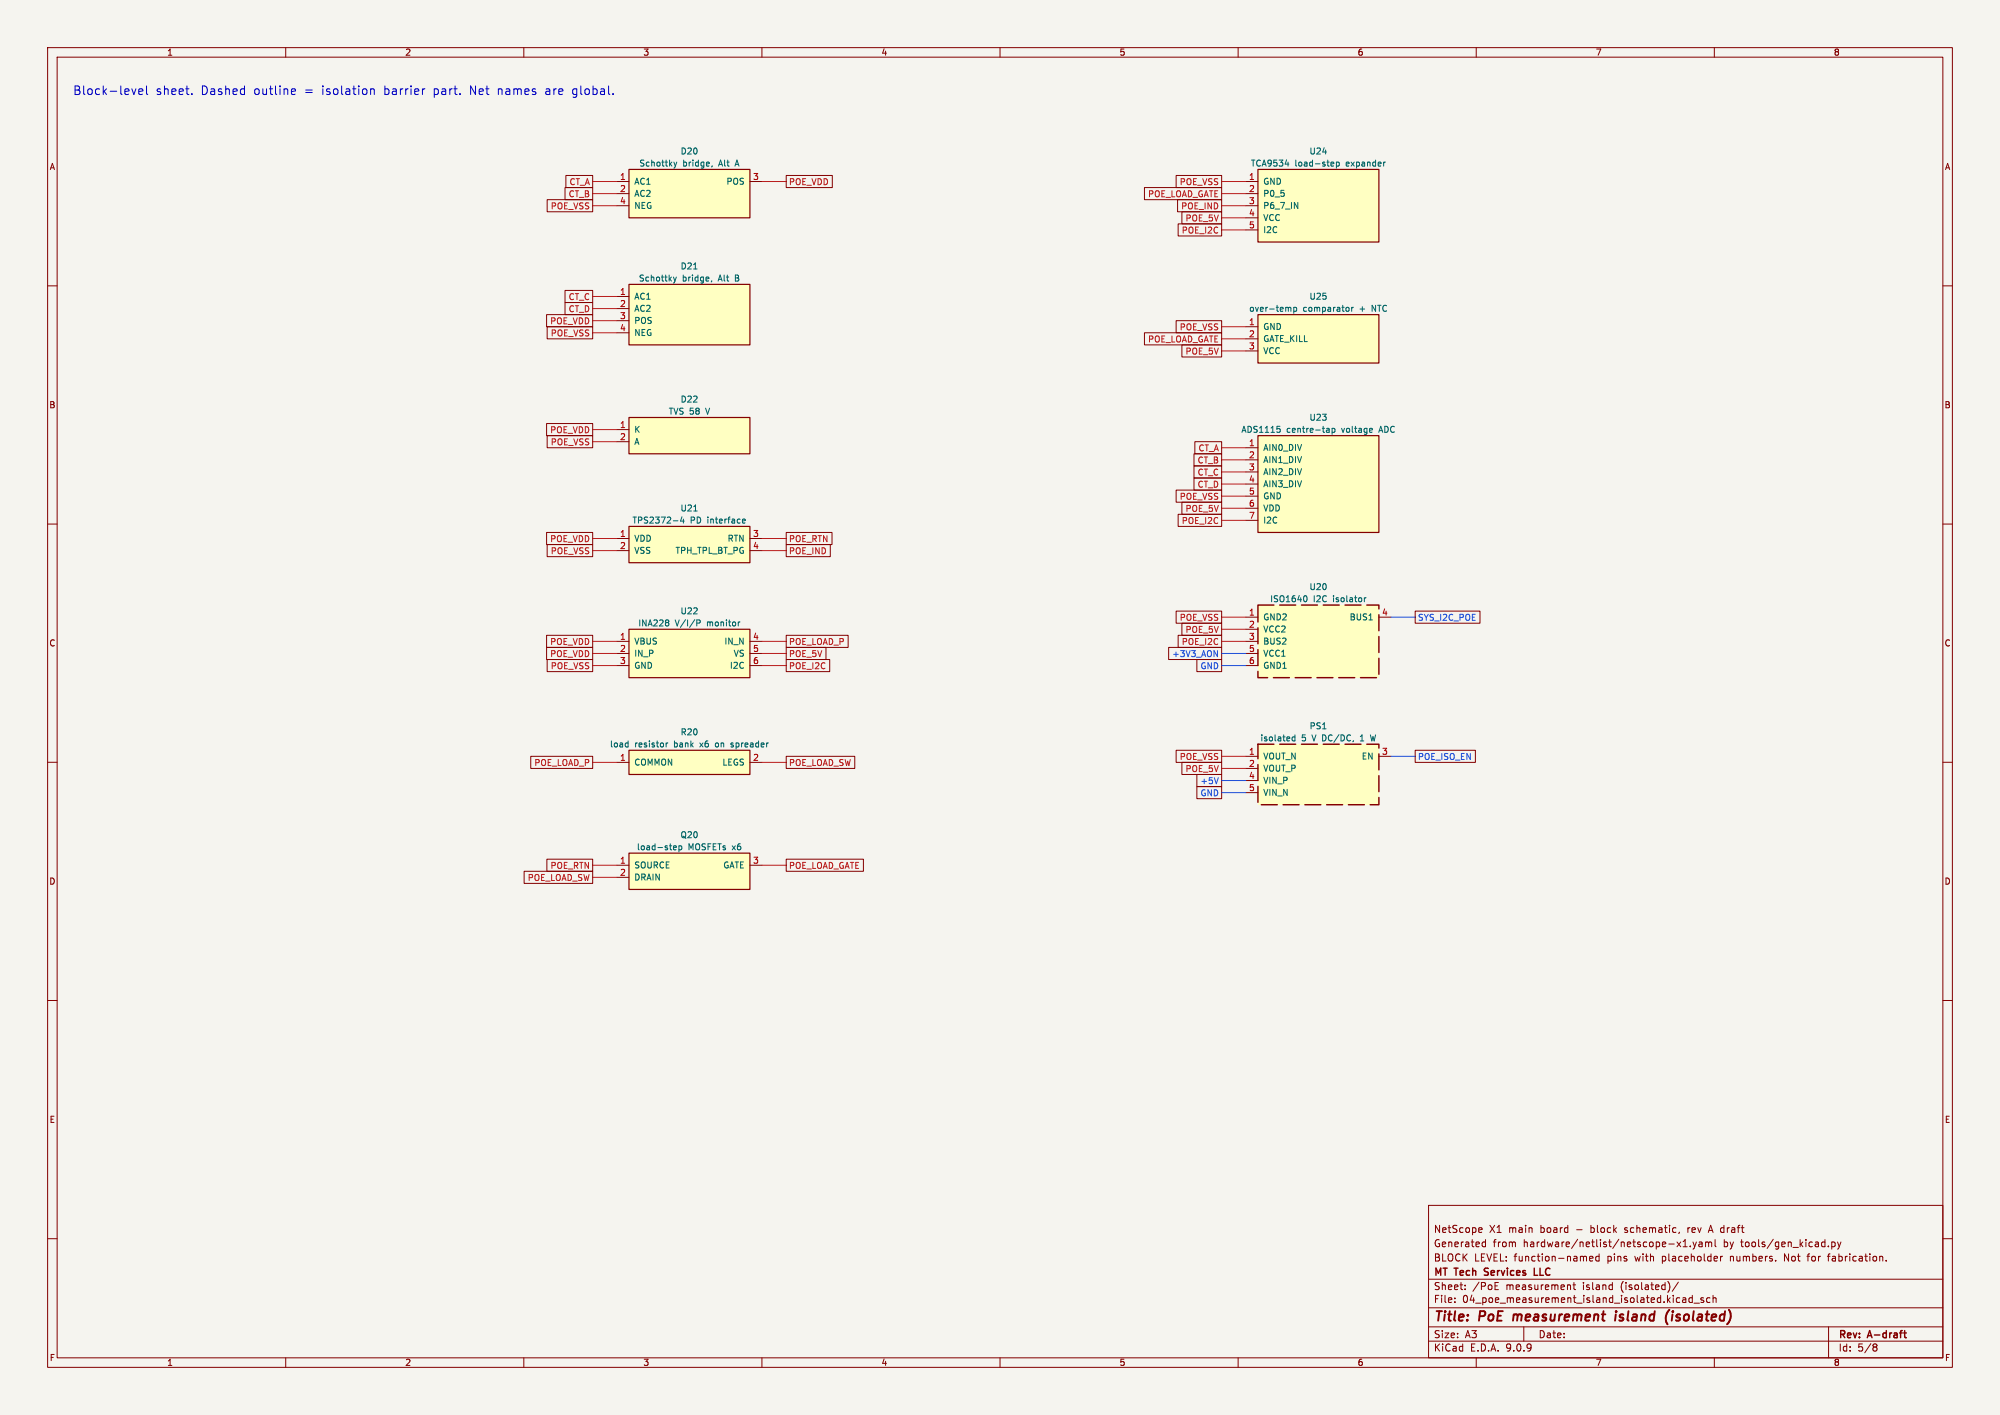
[picture p24: page 5]
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

Tech Services | measurement LLC island (isolated)/ MT Id: 5/8 Title: PoE measurement island (isolated) File: 04_poe_measurement_island_isolated.kicad_sch Sheet: /PoE

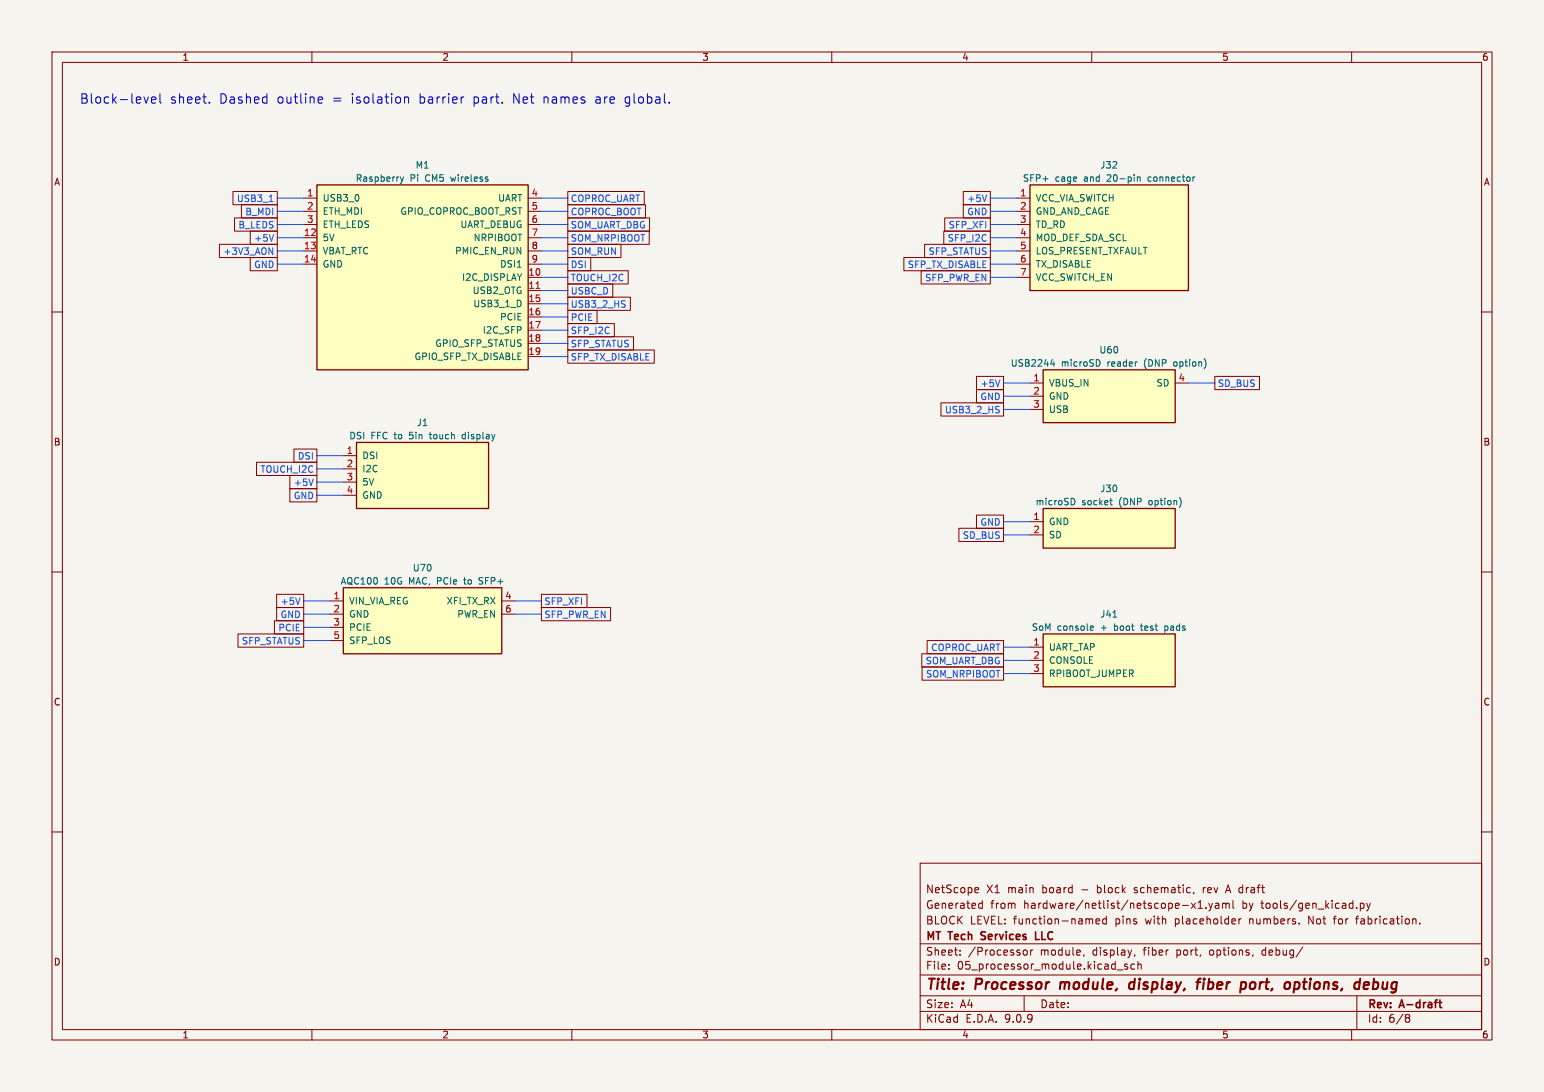
[picture p25: page 6]

I2C_SFP 17 GPIO_SFP_STATUS 18 GPIO_SFP_TX_DISABLE 19 M1 Raspberry Pi CM5 wireless DSI 1

J1 DSI FFC to 5in touch display SFP_STATUS

Id: 6/8 Title: Processor module, display, fiber port, options, debug

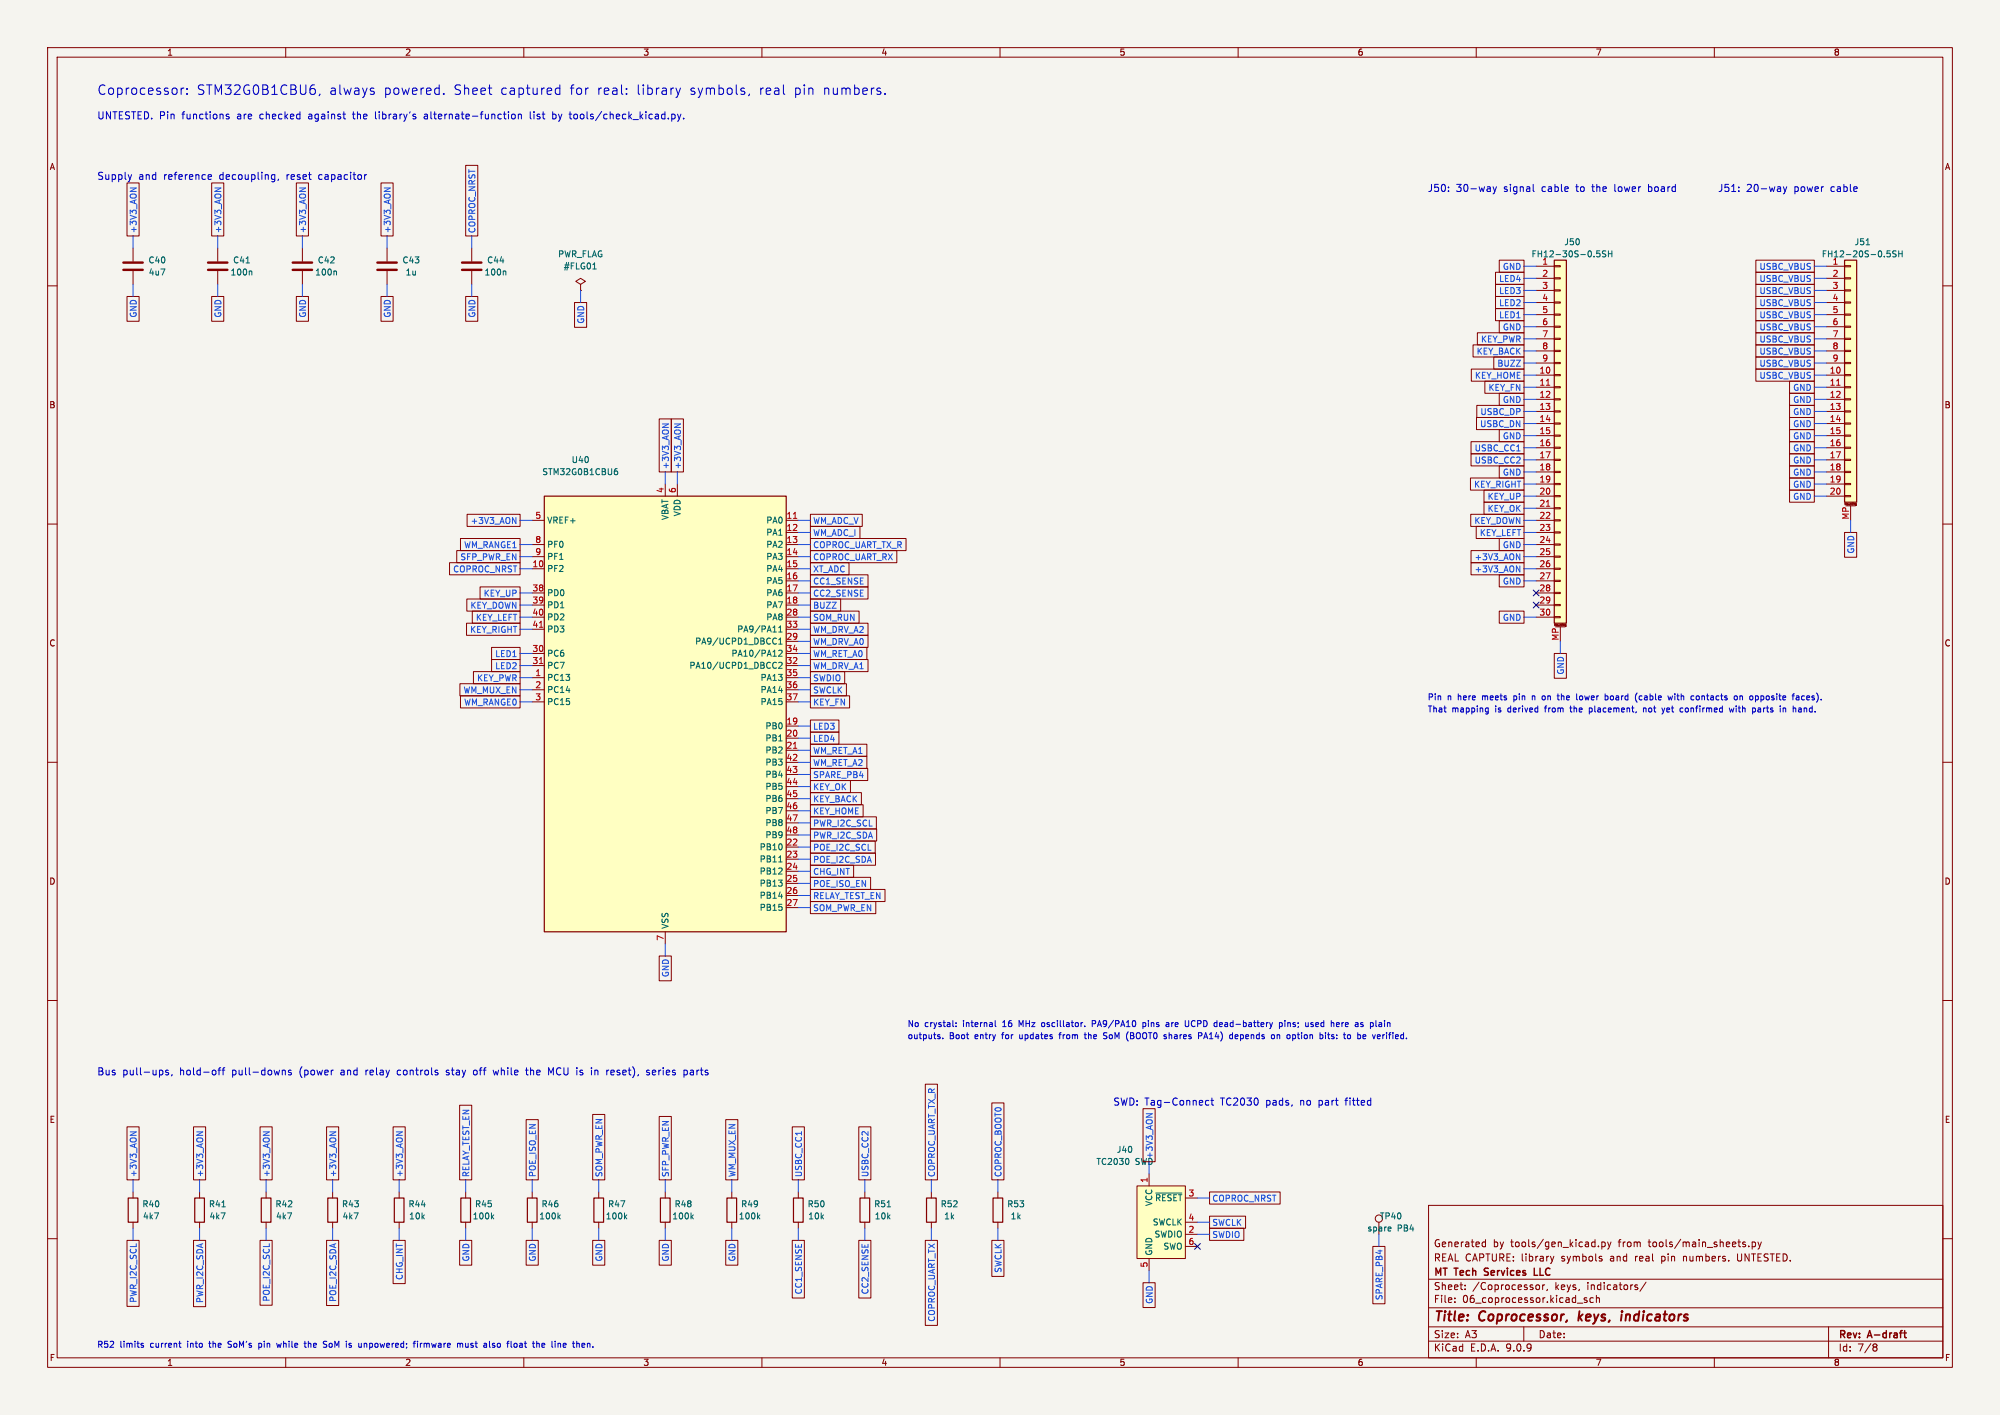
[picture p26: page 7]

5 ~{RESET}3 SWCLK 4 SWDIO 2 SWO 6

Id: 7/8 Title: Coprocessor, keys, indicators

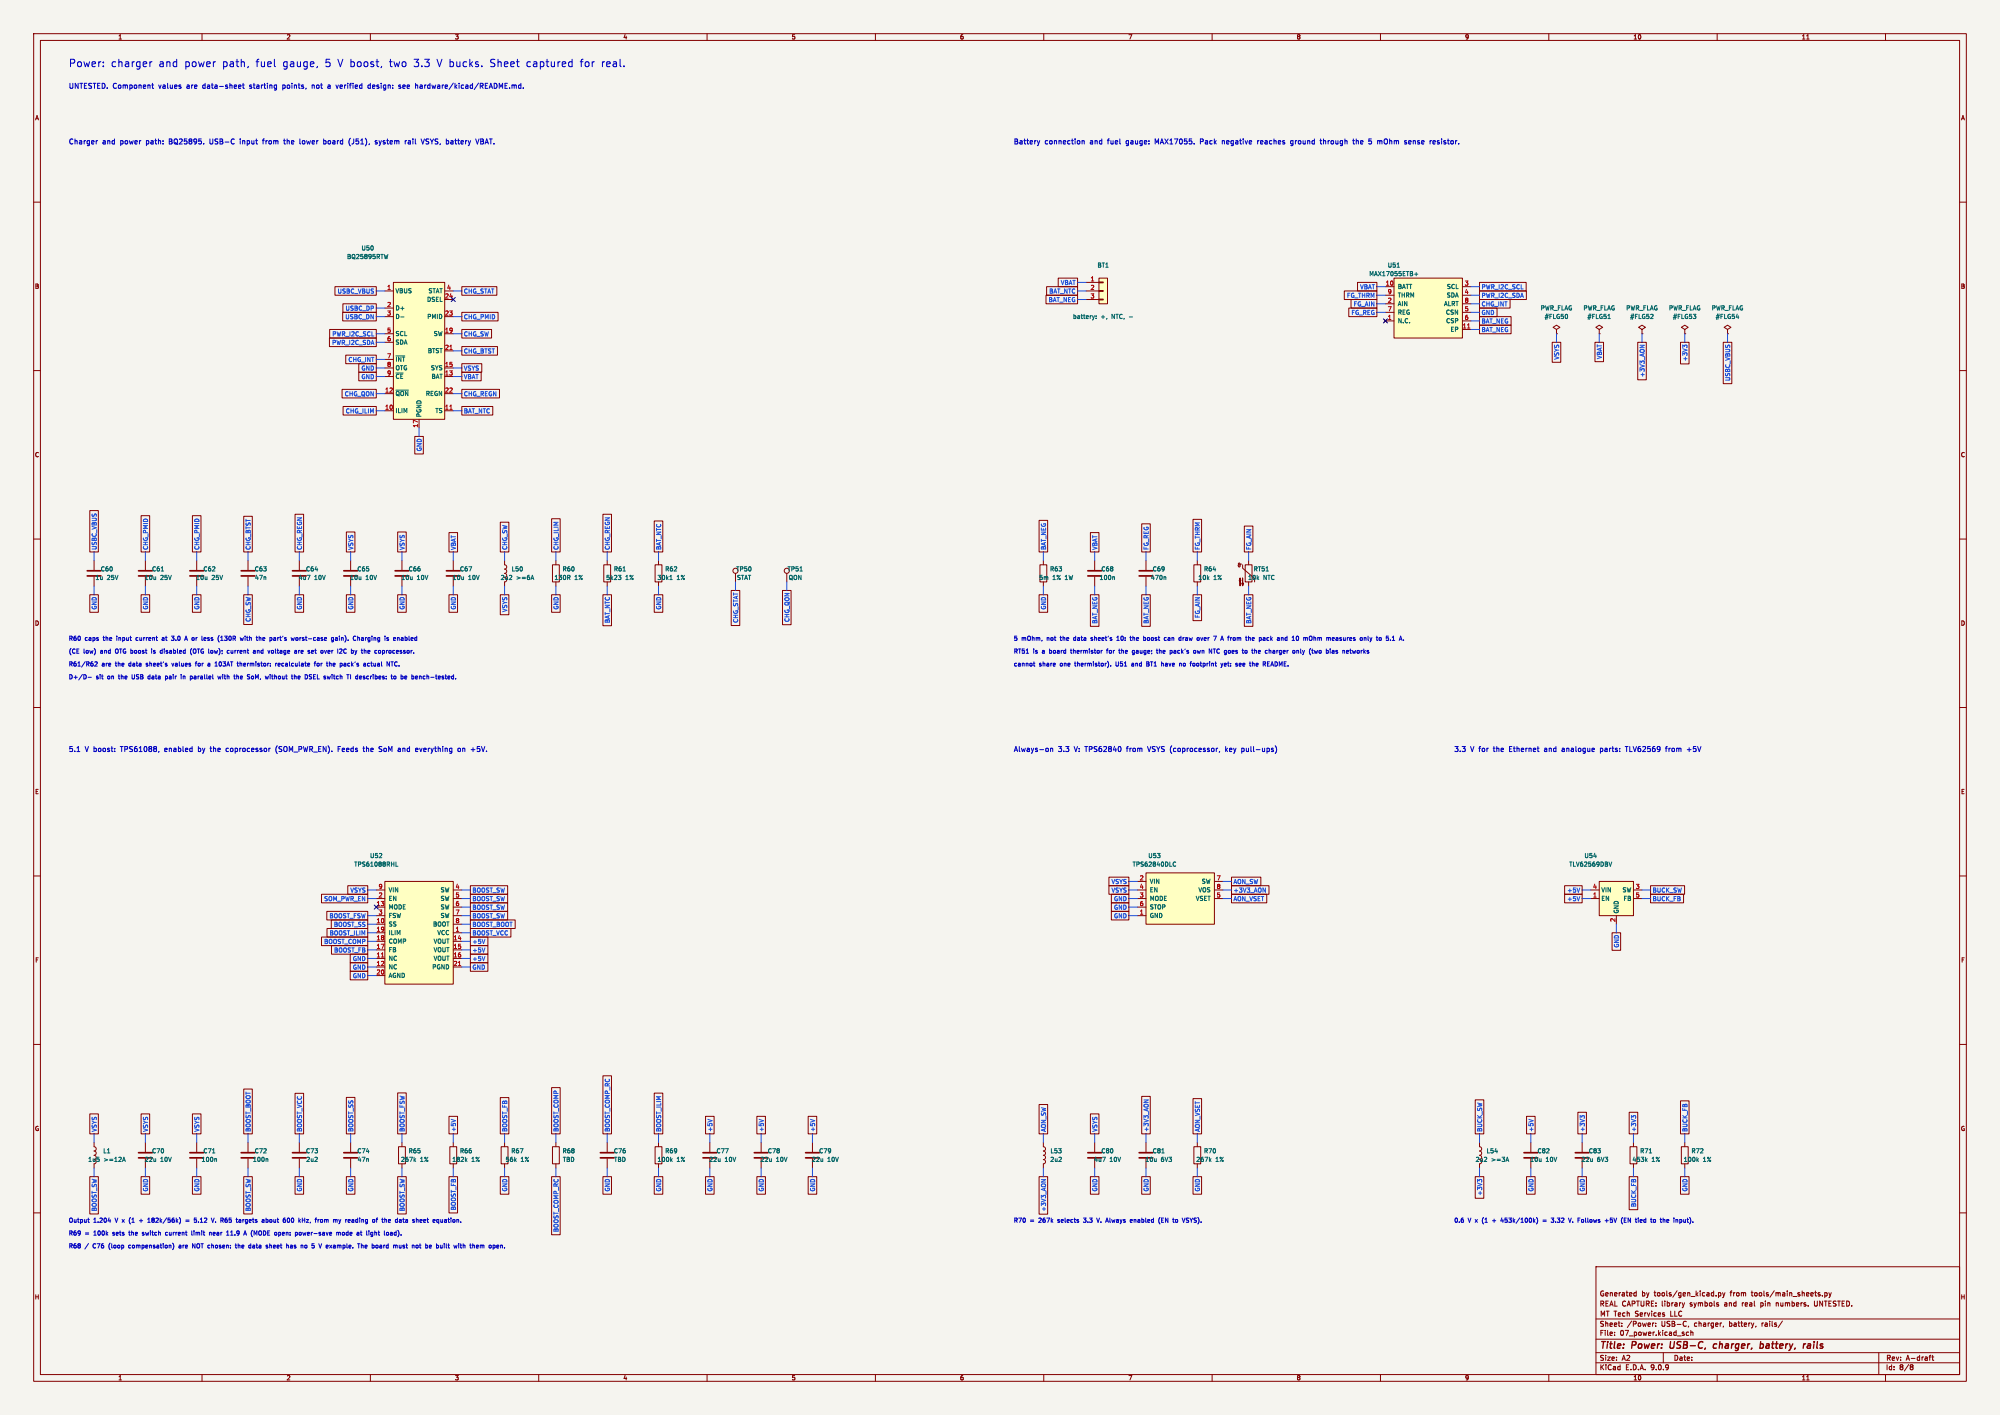
[picture p27: page 8]

Power: charger and power path, fuel gauge, 5 V boost, two 3.3 V bucks. Sheet captured for real.

Charger and power path: BQ25895. USB-C input from the lower board (J51), system rail VSYS, battery VBAT.

5 mOhm, not the data sheet's 10: the boost can draw over 7 A from the pack and 10 mOhm measures only to 5.1 A.

3.3 V for the Ethernet and analogue parts: TLV62569 from +5V

VIN 9 EN 2 MODE 13 FSW 3 SS 10
