migtam628/NetScope/hardware/kicad/netscope-x1-lower/fab-rev-a/lower-schematic.pdf

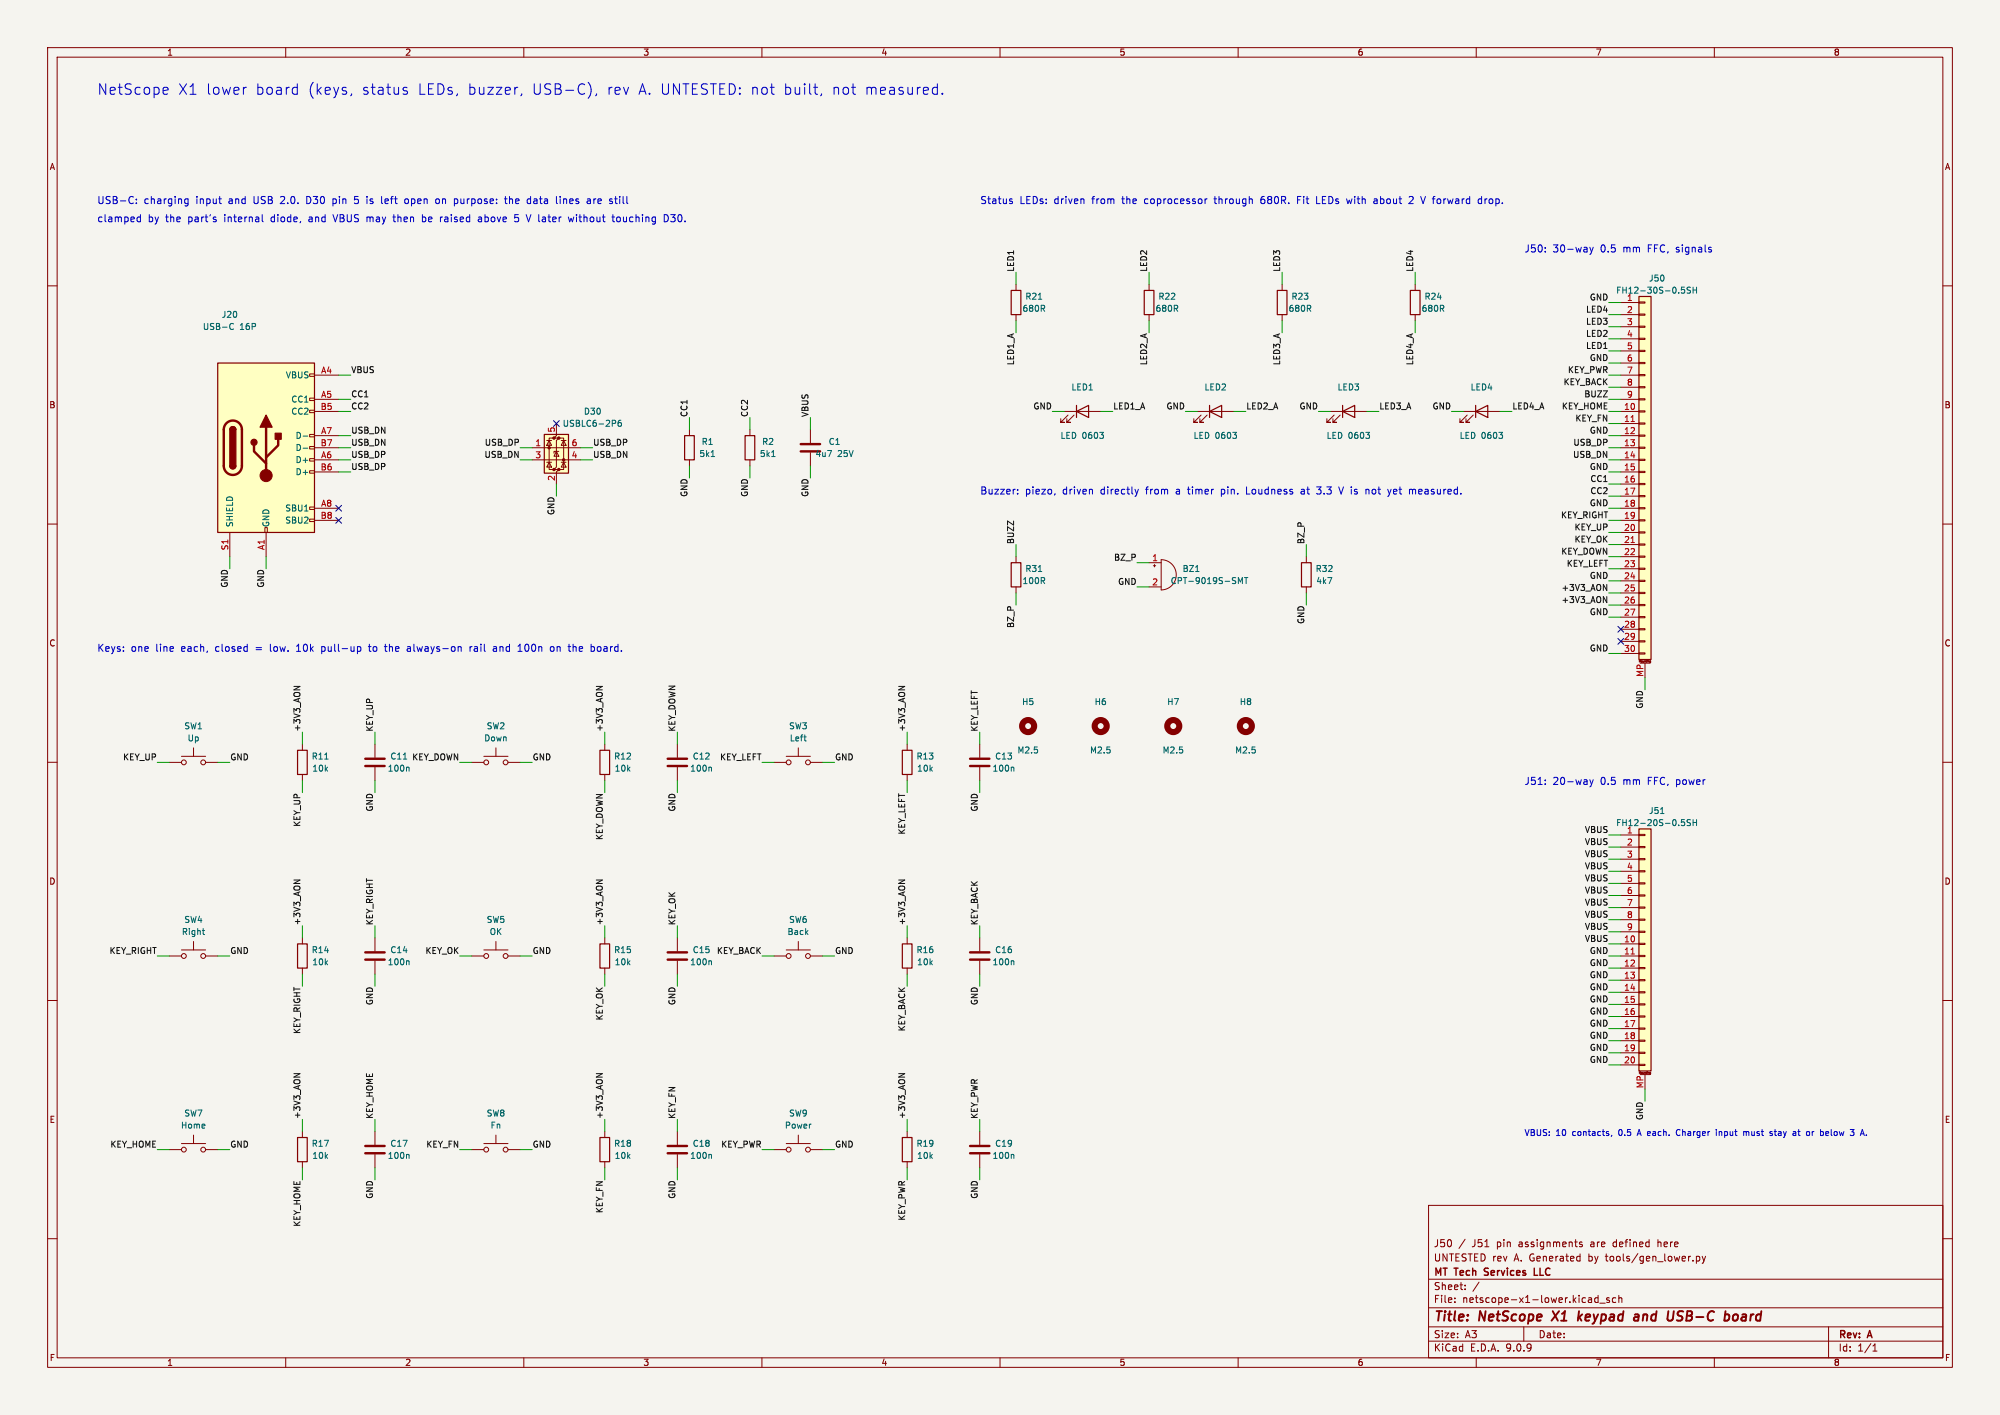
[picture p44: page 1]

Id: 1/1 Title: NetScope X1 keypad and USB-C board
