migtam628/NetScope/(commit log)

2026-11-11 NetScope X1 v0.1.0 baseline: engine, UI, simulator, hardware design data, docs
    Claude-Session: https://claude.ai/code/session_012A9SoTJPeamDGtgkaXSm8U
    [battery_door.3mf, battery_door.step, battery_door.stl, bom.csv, bumper.3mf, bumper.step, bumper.stl, front_shell.3mf]
2026-11-11 Next phase: dev-kit spike kit list, procedures and pass criteria; BOM candidates
    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
    [bom.csv]
2026-11-11 Block schematics for the bench kit and the main board, generated from netlists
    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
2026-11-11 Two-board floorplan with fit checks; housing model with boards, standoffs and review renders
    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
    [battery_door.3mf, battery_door.step, bumper.3mf, bumper.step, front_shell.3mf, front_shell.step, front_shell.stl, netscope_x1_assembly.step]
2026-11-11 microSD on a board tab with a side-wall slot; power key opening
    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
    [battery_door.3mf, battery_door.step, bumper.3mf, bumper.step, bumper.stl, front_shell.3mf, front_shell.step, front_shell.stl]
2026-11-11 Add 10G SFP+ fiber port in place of the M.2 option; re-plan main board and housing openings
    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
    [battery_door.3mf, battery_door.step, bom.csv, bumper.3mf, bumper.step, bumper.stl, front_shell.3mf, front_shell.step]
2026-11-11 Non-commercial licences; fiber controller sourcing check and bench step
    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
    [bom.csv]
2026-11-11 BOM for two boards and link cables; fallback 10G controller; TDR length calibration
    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
    [bom.csv]
2026-11-11 KiCad 9 project generated from the block netlist, with a KiCad-run checker
    Block-level only: function-named pins, no footprints, no layout. Board file
    holds the outline, mounting holes and placement guides from the floorplan.
    tools/check_kicad.py runs ERC, compares KiCad's netlist with the YAML
    netlist, checks domain net classes and proves the isolation rules fire.
    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
    [01_port_a.kicad_sch, 02_test_port_mac_and_phy.kicad_sch, 03_wiremap_front_end.kicad_sch, 04_poe_measurement_island_isolated.kicad_sch, 05_processor_module.kicad_sch, 06_coprocessor.kicad_sch, 07_power.kicad_sch, netscope-x1.kicad_pcb]
2026-11-11 RT-1 remote terminator rev A: KiCad capture, routed board, Gerbers, checker
    Schematic is generated from the firmware's terminator definition; the board
    is placed and routed by script with KiCad's Python API. tools/check_rt1.py
    runs ERC, compares the netlist with the firmware, and runs DRC with
    schematic parity. Not fabricated. The earlier series-fuse protection idea is
    withdrawn: no fuse trips at 12-57 mA; rev A uses 2512 resistor footprints.
    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
    [bom.csv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]
2026-11-11 CI: retry adding the KiCad package source when Launchpad is unreachable
    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
2026-11-11 CI: run the KiCad checks in KiCad's official container image
    The Launchpad package archive was unreachable from the runner; the image
    removes that dependency.
    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
2026-11-12 Lower (keypad and USB-C) board rev A: KiCad capture, routed board, Gerbers
    Real library symbols and footprints, placed from the floorplan and routed by
    the project's own grid router (tools/gridrouter.py). tools/check_lower.py runs
    ERC, checks the cable pin tables, the cross-board nets against the block
    netlist, per-part circuit rules, and DRC with schematic parity. Defines the
    J50/J51 pin assignments for the main board. Not fabricated.
    hardware/kicad/README.md now states what blocks pin-accurate capture of the
    main board: the fiber controller's datasheet is under NDA, 15 parts are not
    selected, and the bench kit has not been run.
    Cla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
    [06_coprocessor.kicad_sch, 07_power.kicad_sch, battery_door.3mf, battery_door.step, bumper.3mf, bumper.step, front_shell.3mf, front_shell.step]
2026-11-13 Main board: coprocessor sheet captured for real; mixed real/block project
    STM32G0B1CBU6 with support parts, SWD pads and the two cable connectors, as
    library symbols with real pins and footprints (tools/main_sheets.py). The
    checker proves the sheet still implements the block netlist, that each
    peripheral function exists on its pin, that power and relay controls have
    hold-off resistors, and that the cable pin tables match the lower board.
    Real footprints are on the board file; nothing is routed.
    Design changes from the capture: QFN instead of LQFP (height), SFP status
    and TX-disable lines to the SoM (pin count), cable connectors on the back
    (height), debug header split. Open: the signal cabl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
    [05_processor_module.kicad_sch, 06_coprocessor.kicad_sch, battery_door.3mf, battery_door.step, bom.csv, bumper.3mf, bumper.step, front_shell.3mf]
2026-11-13 Main board: power sheet captured for real; open items tracked by the checker
    BQ25895, MAX17055, TPS61088, TPS62840, TLV62569 and their support parts as
    real symbols with real pins. Three parts without a library symbol are drawn
    from data-sheet pin tables (to be compared with the PDFs before ordering).
    Not buildable yet: boost compensation values and two footprints are open;
    tools/check_kicad.py fails if that list and the schematic disagree.
    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
    [07_power.kicad_sch, bom.csv, netscope-x1.kicad_pcb]
